AlexPeirano/neck_cst_simulation/README.md

# neck_cst_simulation
This repository contains scripts to analyse CST simulations of a modeled neck and antennas.
