AlexPeirano/neck_cst_simulation/final/diapo_final.pptx.pdf

# Design and Manufacturing of Low-Cost Antennas for

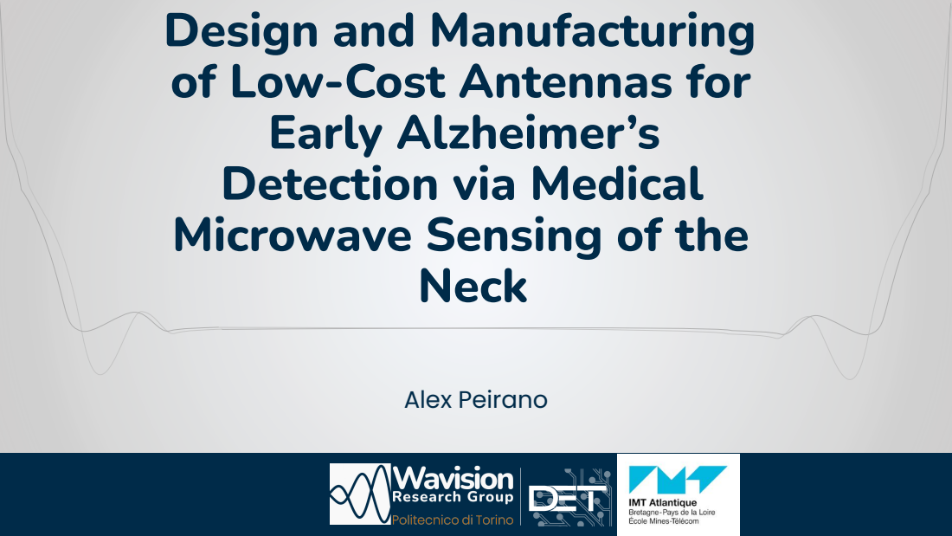
[picture p1: page 1]
Neck; Alex Peirano

Early Alzheimer’s
Detection via Medical
Microwave Sensing of the

# MultiTissue block

# CST Model Coupling

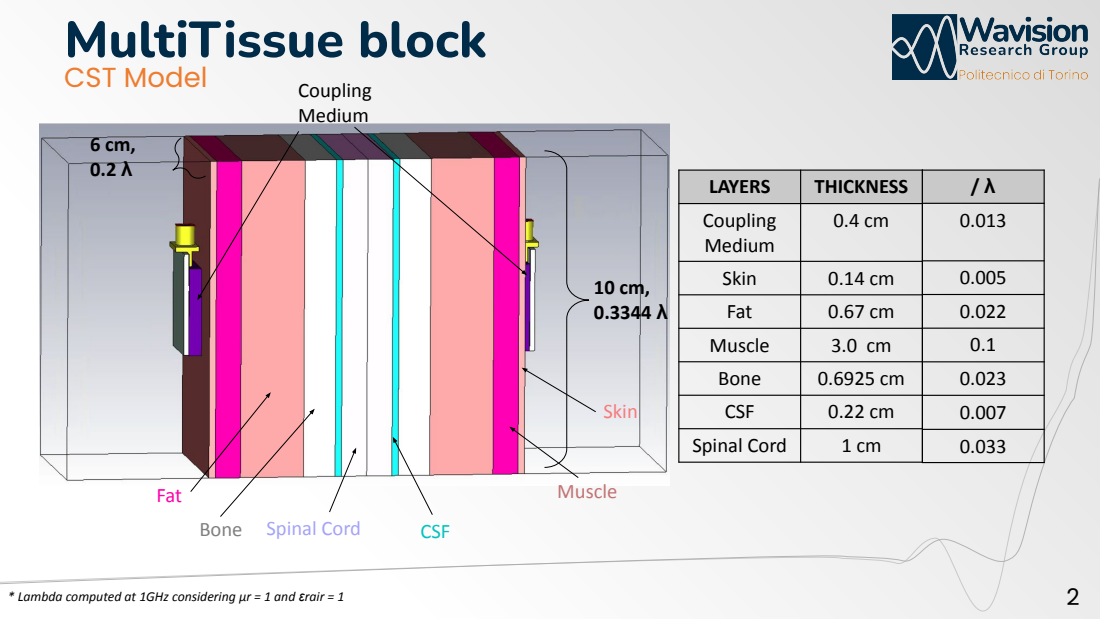
[picture p2: page 2]
Medium; Skin; Fat; Muscle; Bone; Spinal Cord; CSF; * Lambda computed at 1GHz considering μr = 1 and ɛrair = 1

LAYERS | THICKNESS | / λ
Coupling Medium | 0.4 cm | 0.013

Fat | 0.67 cm | 0.022
Muscle | | 3.0 cm | 0.1
Bone | | 0.6925 cm | 0.023

# Simulations Boundary conditions

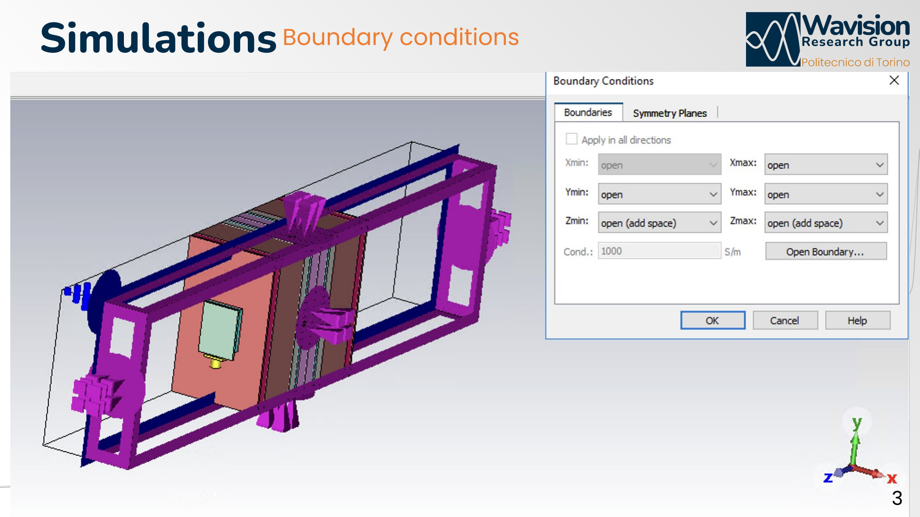
[picture p3: page 3]

3

# Simulations Boundary conditions

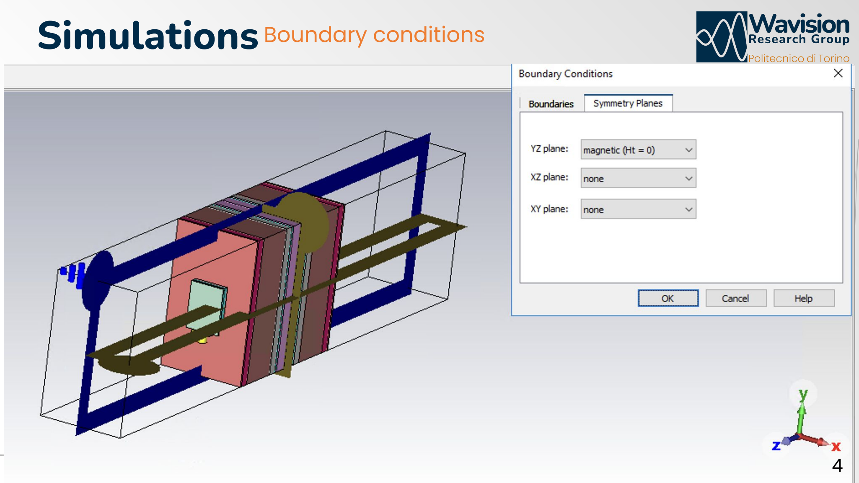
[picture p4: page 4]

4

# Simulations

# Refining the mesh

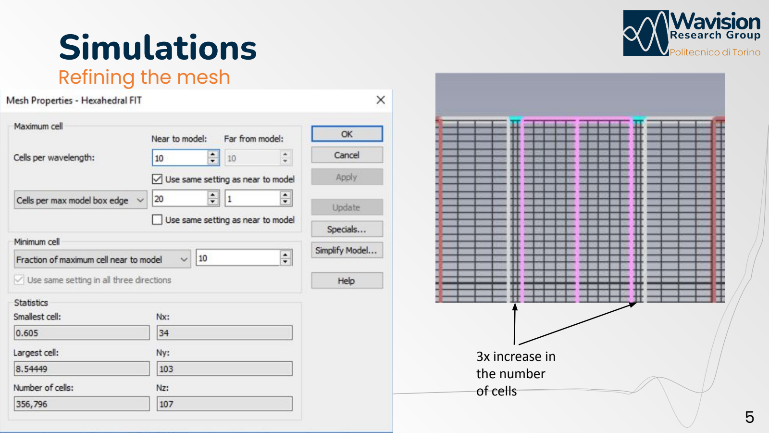
[picture p5: page 5]

5

## 3x increase in the number of cells

24 mm

# Optimized Antenna Ring topology

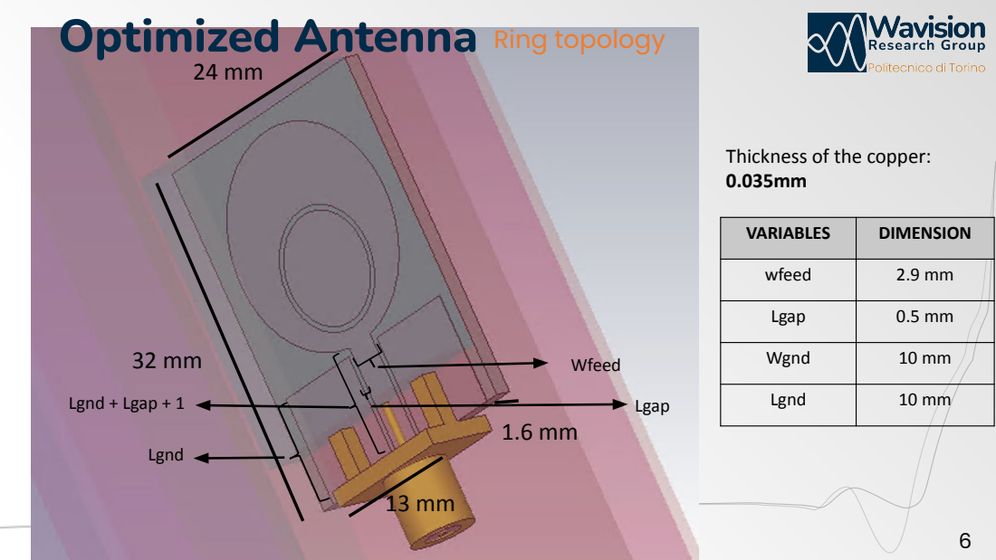
[picture p6: page 6]
Wfeed; Lgnd; Lgnd + Lgap + 1; Lgap

Thickness of the copper:

VARIABLES | DIMENSION

wfeed | 2.9 mm

Lgap | 0.5 mm

Wgnd | 10 mm

# Optimized Antenna Ring topology

LAYERS | DIMENSION
R_ext | R_m - w_slot/2
R_int | R_m + w_slot/2
R_m | 4.03 mm
w_slot | 0.5 mm

7

## R_ext

## R_int R_m

LAYERS | DIMENSION

## Y_offset

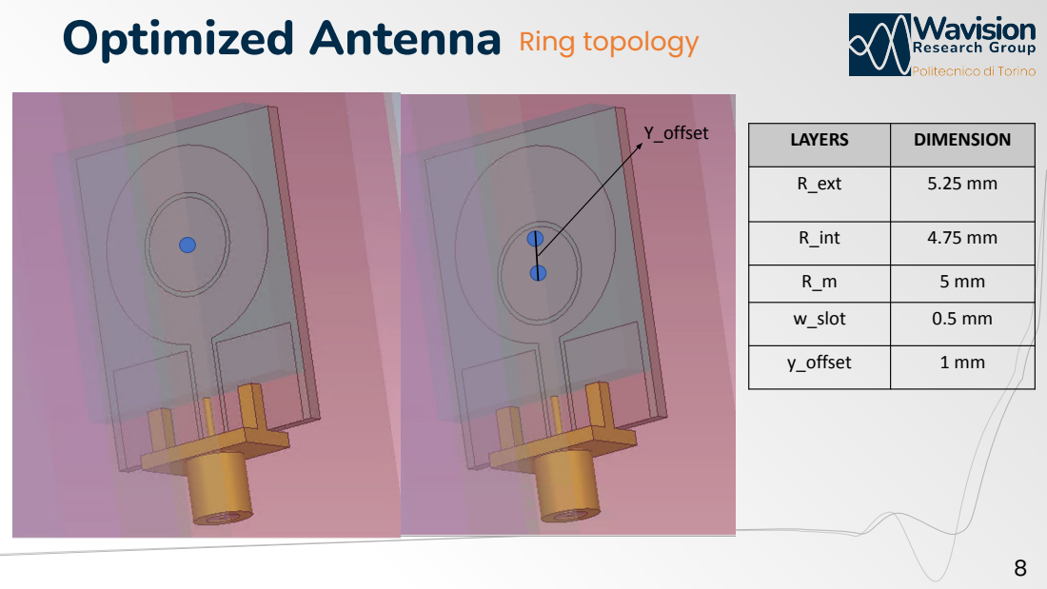
[picture p7: page 8]

Optimized Antenna Ring topology

R_ext | 5.25 mm

R_int | 4.75 mm

w_slot | 0.5 mm

y_offset | 1 mm

# Preliminary computations

# Ring Topology

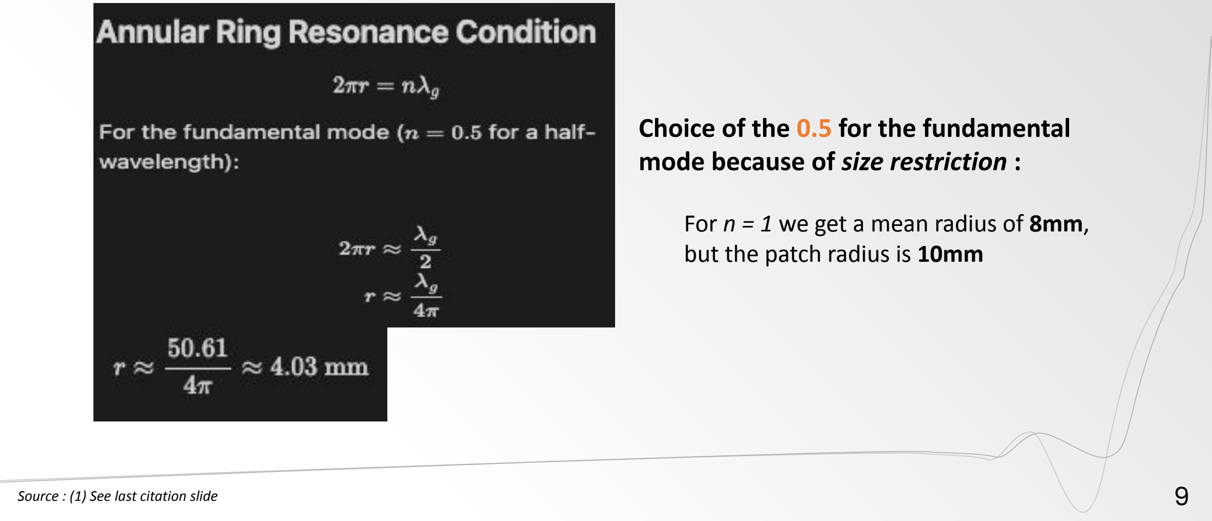
[picture p8: figure]
Choice of the 0.5 for the fundamental mode because of size restriction :; For n = 1 we get a mean radius of 8mm, but the patch radius is 10mm; Source : (1) See last citation slide

# Simulations

# Ring topology

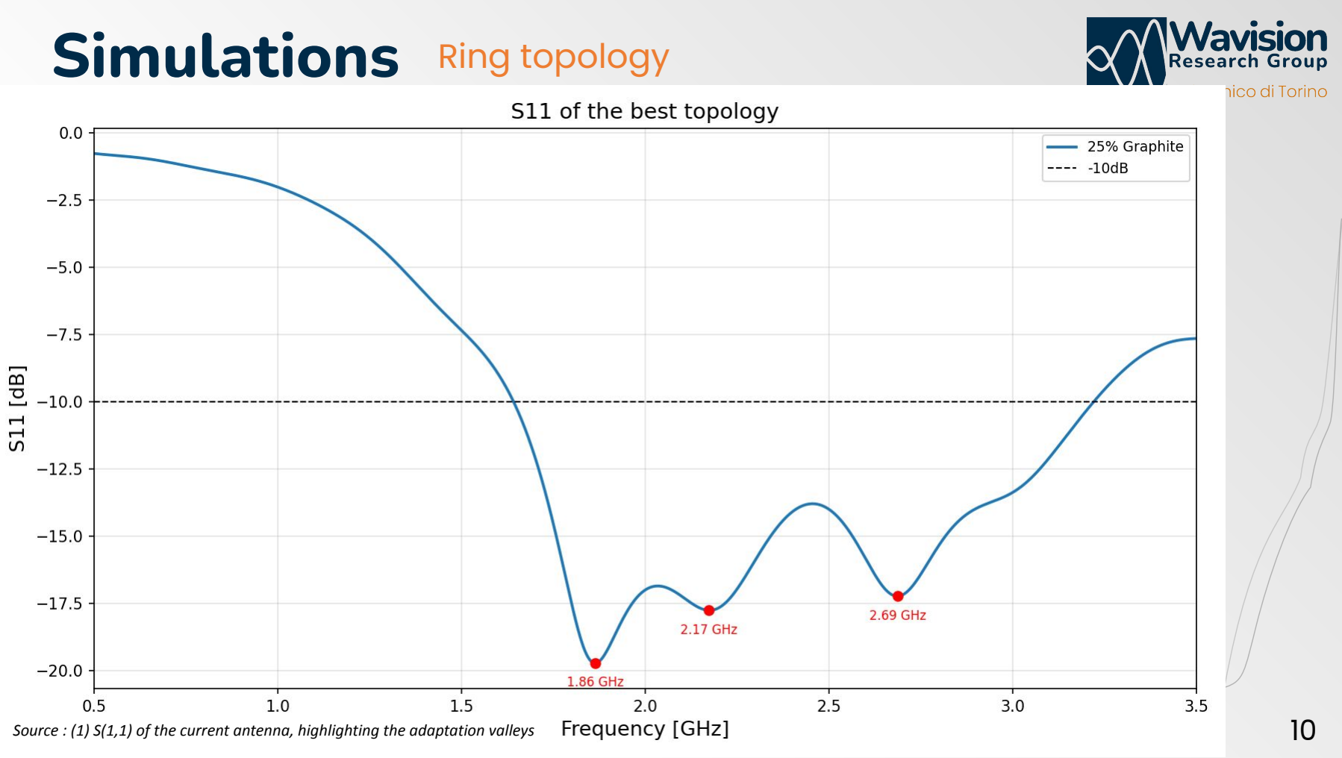
[picture p9: page 10]

Source : (1) S(1,1) of the current antenna, highlighting the adaptation valleys | 10

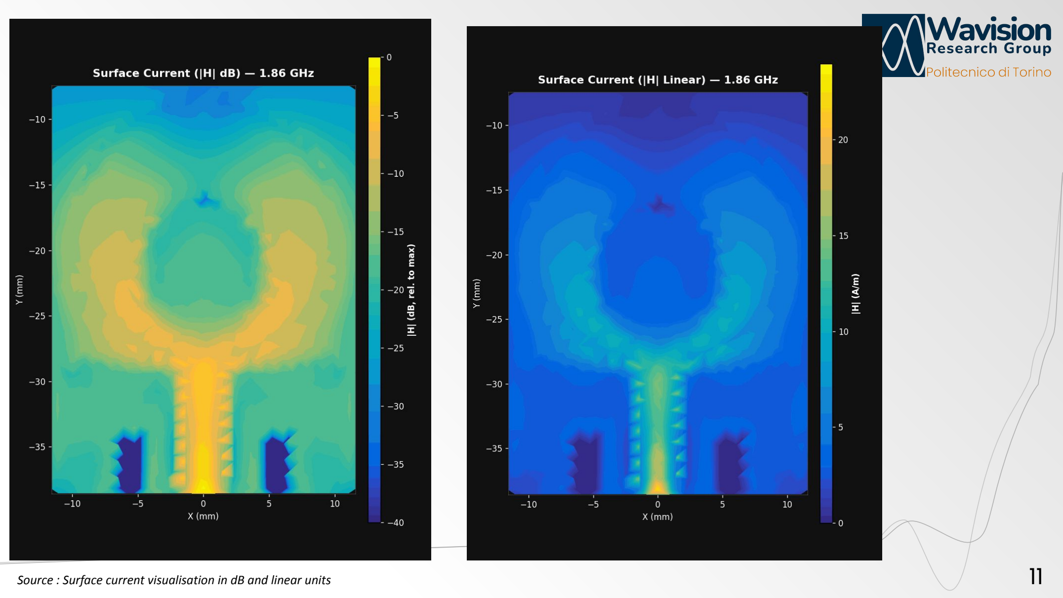
[picture p10: page 11]

Source : Surface current visualisation in dB and linear units | 11

1) | 2) | 3)

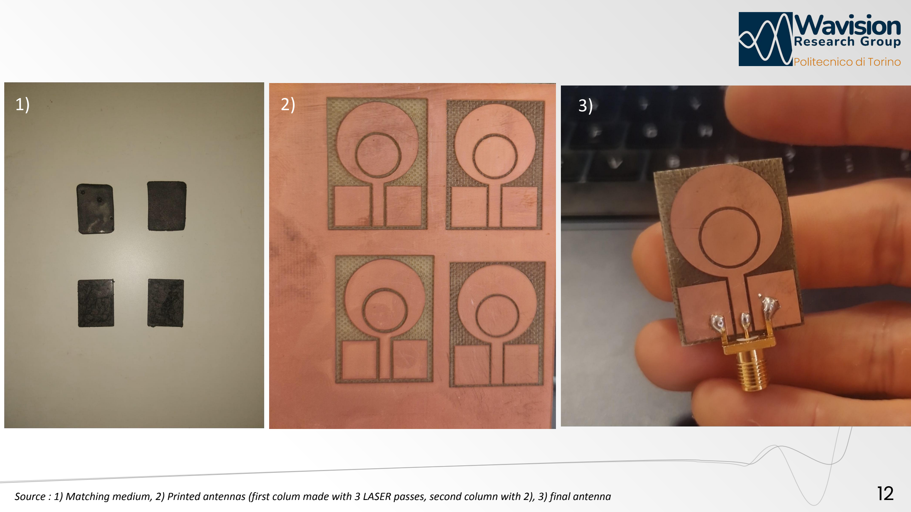
[picture p11: page 12]

Source : 1) Matching medium, 2) Printed antennas (first colum made with 3 LASER passes, second column with 2), 3) final antenna | 12

# Simulations

# Ring topology

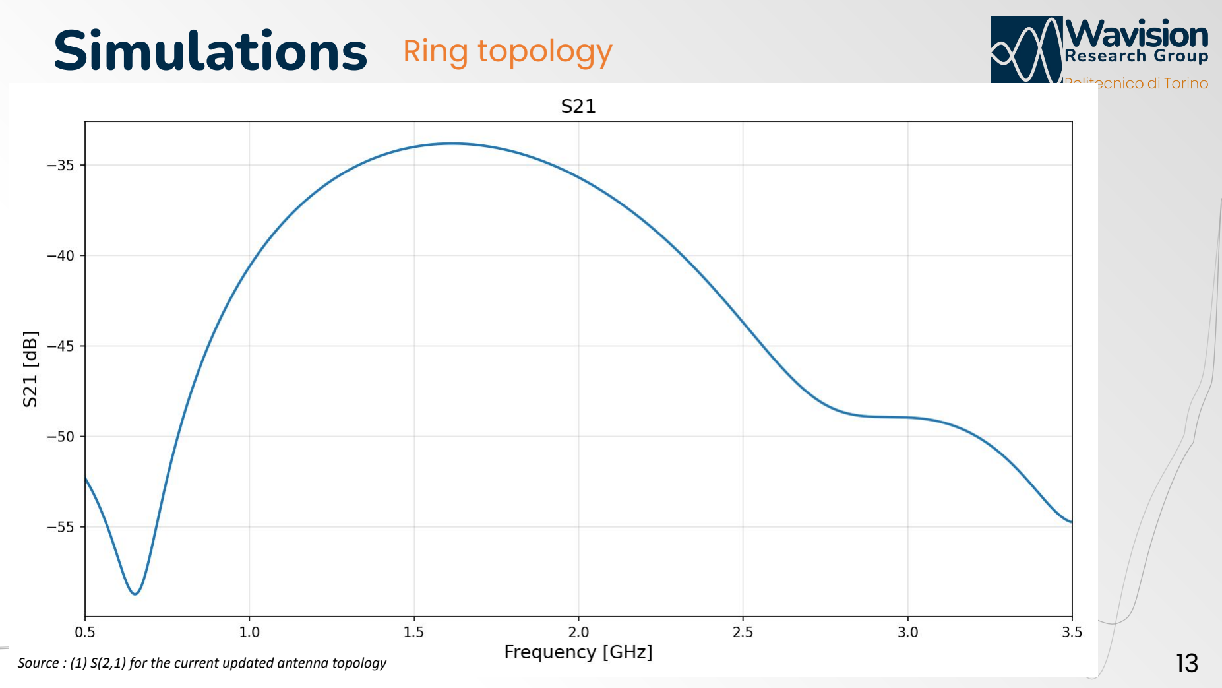
[picture p12: page 13]

Source : (1) S(2,1) for the current updated antenna topology | 13

Simulations | Electric Field (dB)

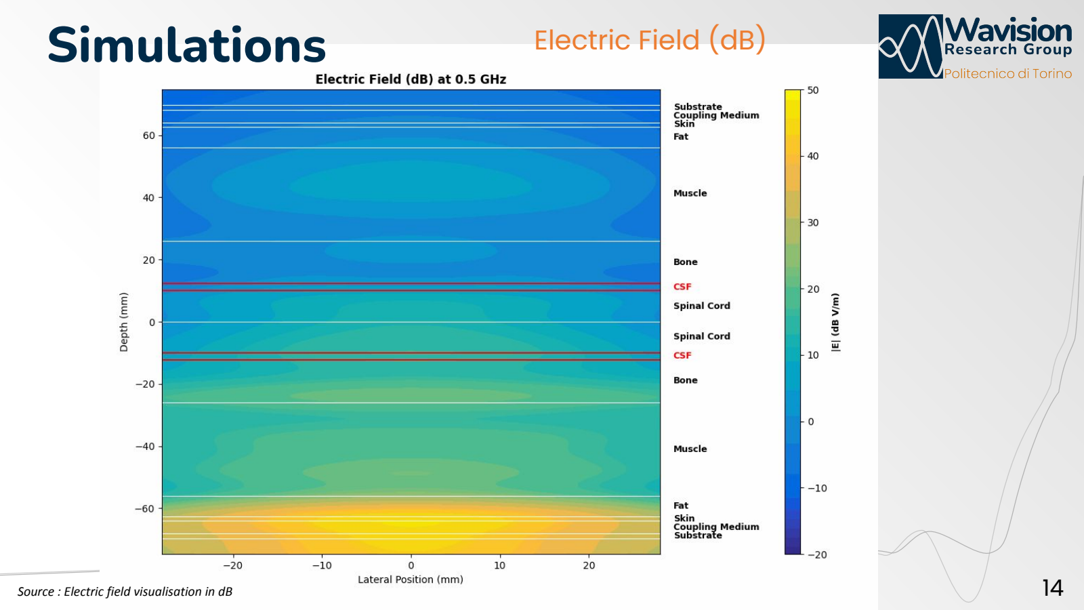
[picture p13: page 14]

| 14

Source : Electric field visualisation in dB

Simulations | E-field (linear)

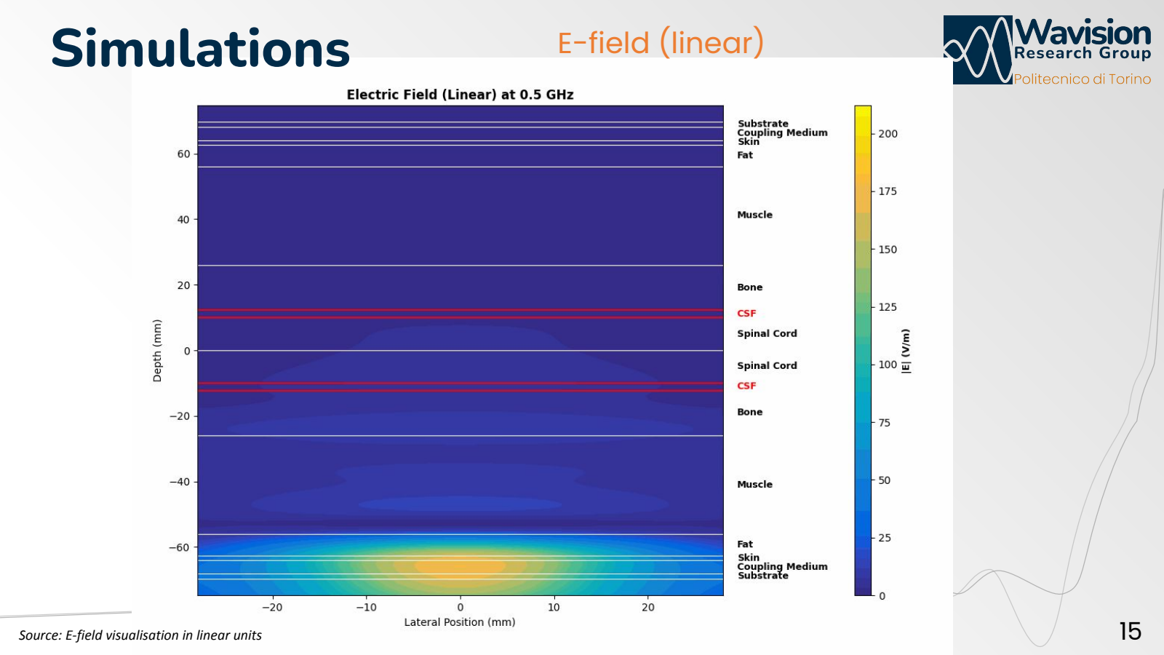
[picture p14: page 15]

| 15

Source: E-field visualisation in linear units

# Simulations Normalized E-field (dB)

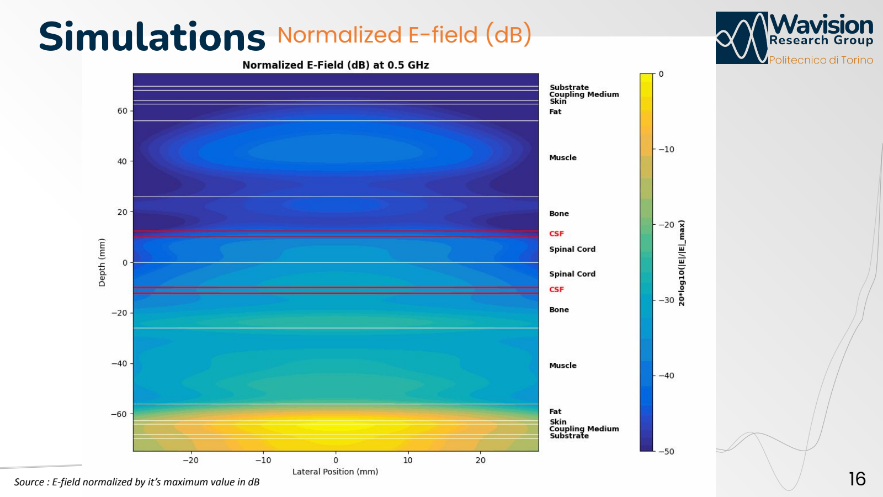
[picture p15: page 16]

| 16

Source : E-field normalized by it’s maximum value in dB

# Simulations Normalized E-field visualization

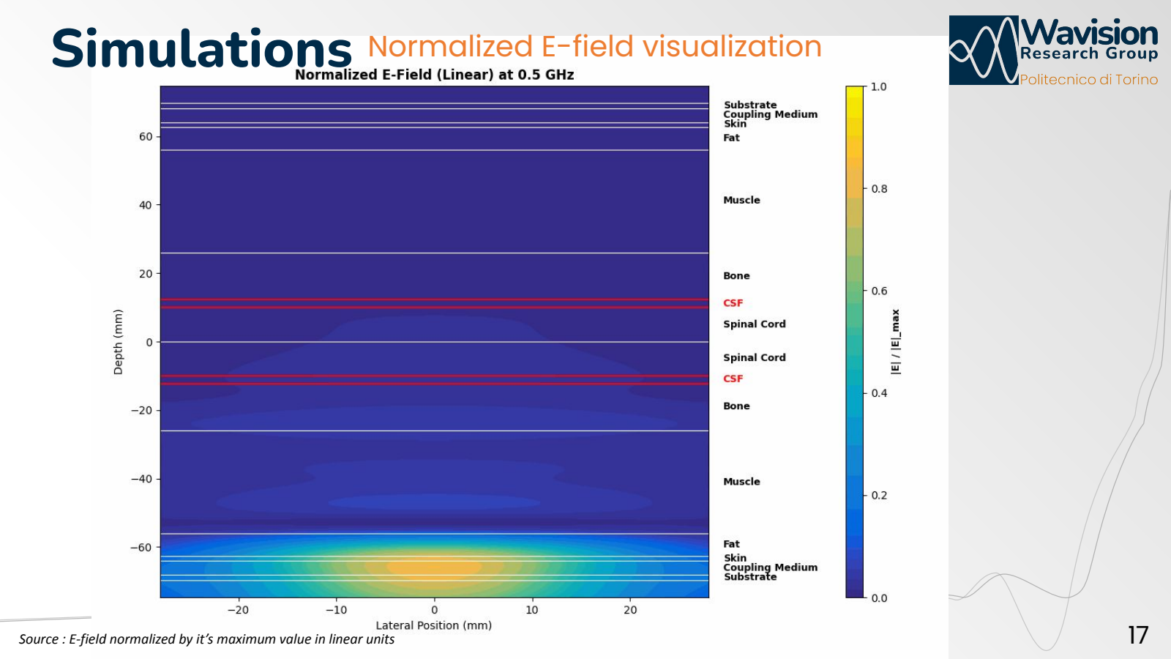
[picture p16: page 17]

| 17

Source : E-field normalized by it’s maximum value in linear units

# Simulations Changing the % of graphite

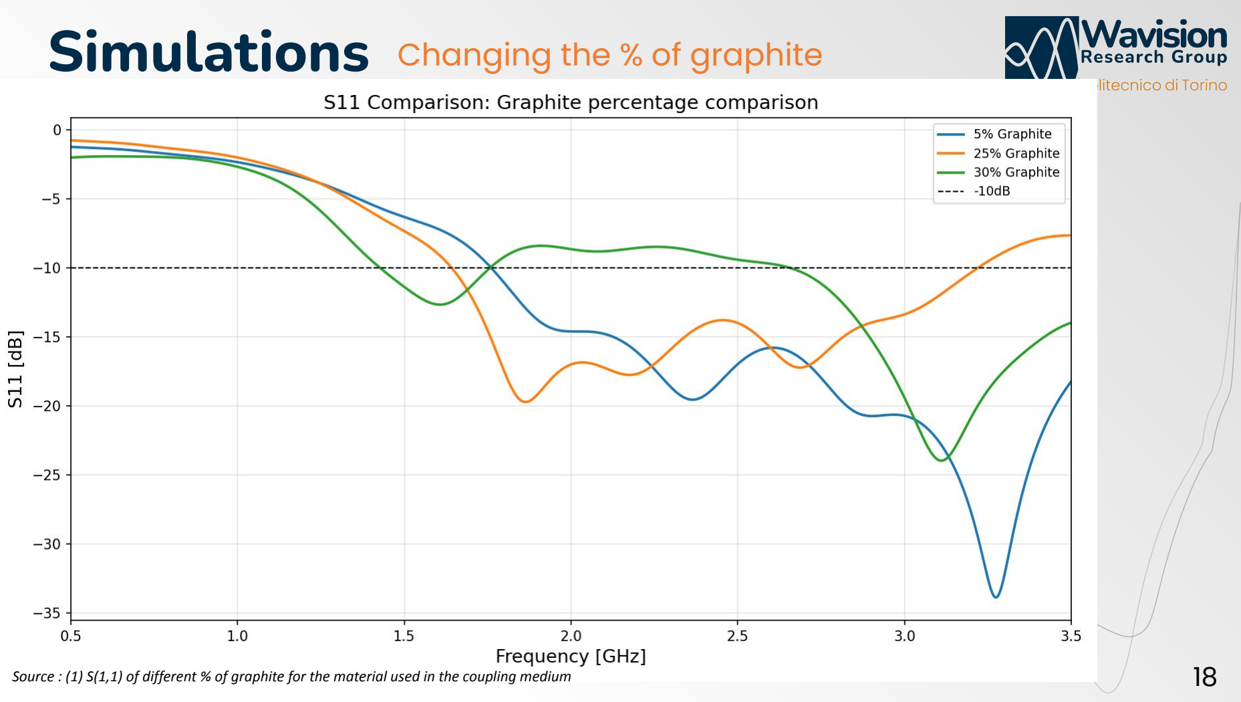
[picture p17: page 18]

Source : (1) S(1,1) of different % of graphite for the material used in the coupling medium | 18

# Simulations

# Changing the % of graphite

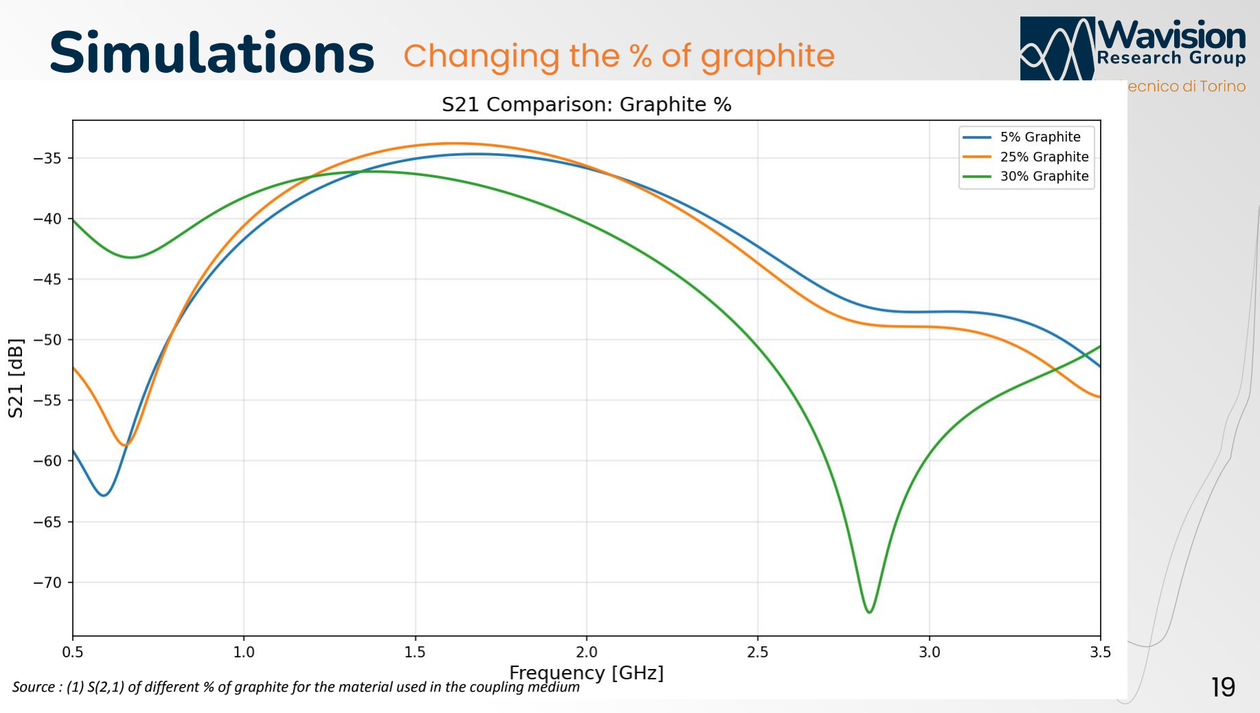
[picture p18: page 19]

Source : (1) S(2,1) of different % of graphite for the material used in the coupling medium | 19

# Neck thickness

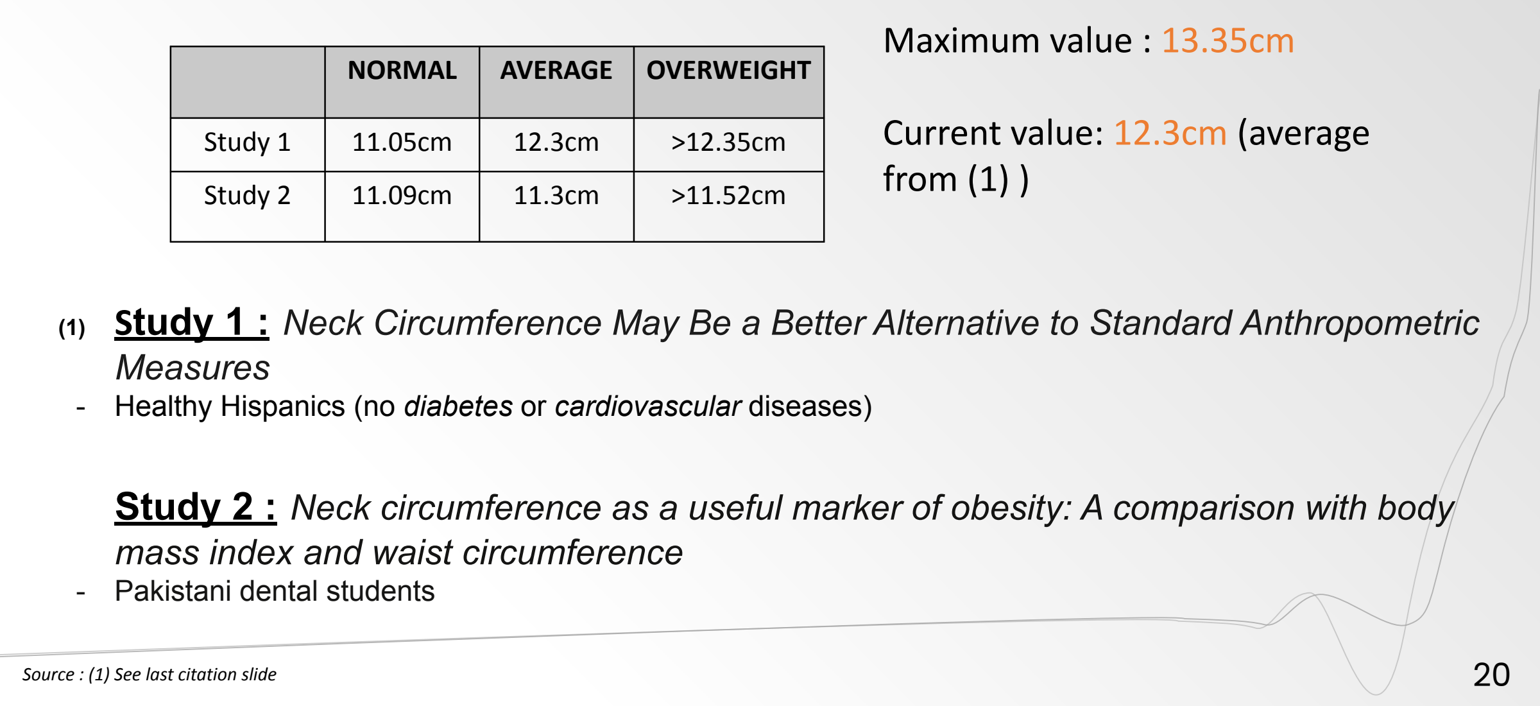
[picture p19: figure]
NORMAL; AVERAGE; OVERWEIGHT; Study 1; Study 2; Measures; mass index and waist circumference; - Pakistani dental students; Maximum value : 13.35cm; Current value: 12.3cm (average from (1) ); Source : (1) See last citation slide

(1) | Study 1 : | Neck Circumference May Be a Better Alternative to Standard Anthropometric

## - Healthy Hispanics (no diabetes or cardiovascular diseases)

| Study 2 : | Neck circumference as a useful marker of obesity: A comparison with body

# MultiTissue block

# Thicker models

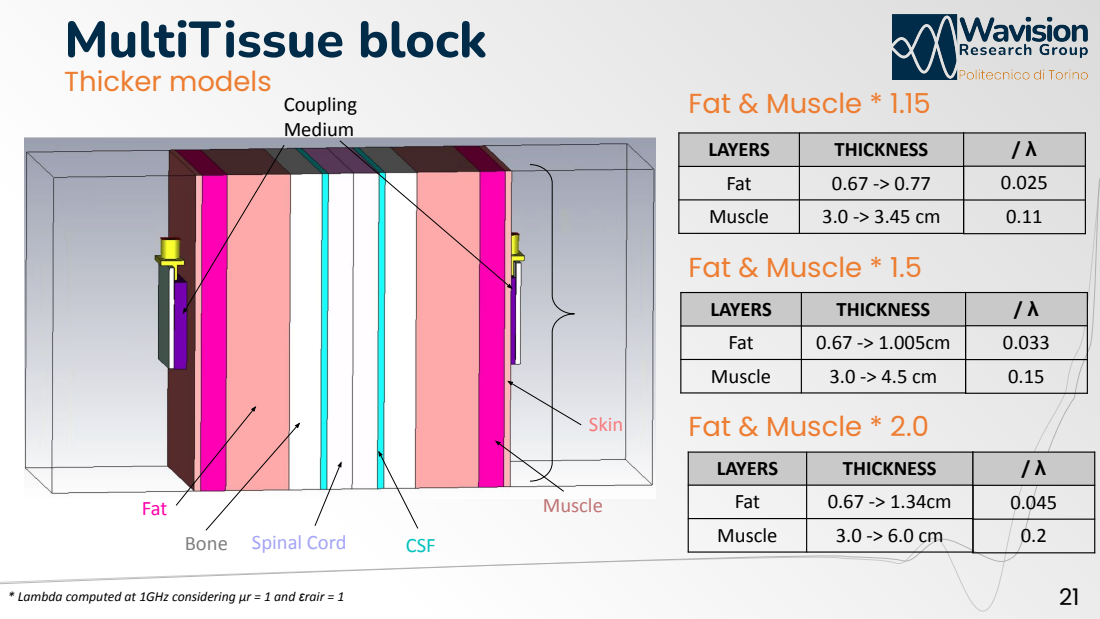
[picture p20: page 21]
Coupling Medium; Skin; Fat; Muscle; Bone; Spinal Cord; CSF; * Lambda computed at 1GHz considering μr = 1 and ɛrair = 1; Fat & Muscle * 1.15; Fat & Muscle * 1.5; Fat & Muscle * 2.0

LAYERS | THICKNESS | / λ
Fat | 0.67 -> 0.77 | 0.025
Muscle | 3.0 -> 3.45 cm | 0.11

Fat | 0.67 -> 1.005cm | 0.033
Muscle | 3.0 -> 4.5 cm | 0.15

Fat | 0.67 -> 1.34cm | 0.045
Muscle | 3.0 -> 6.0 cm | 0.2

# Simulations Thicker necks

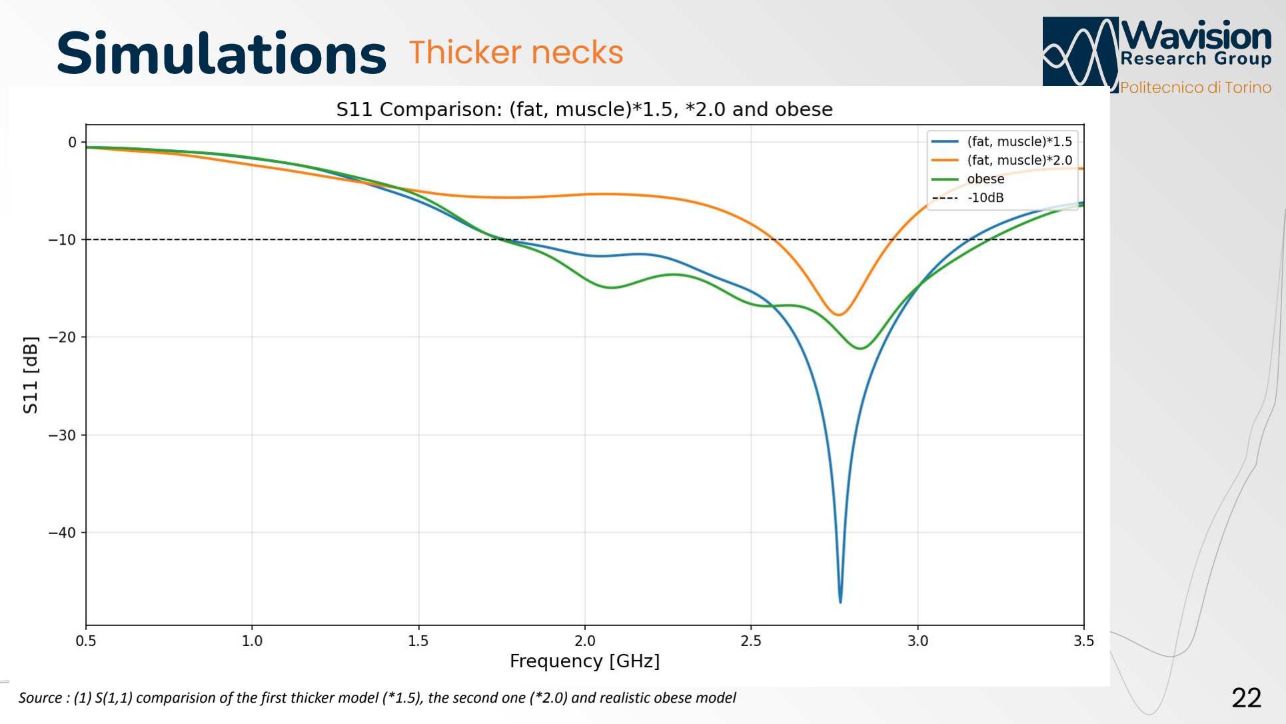
[picture p21: page 22]

Source : (1) S(1,1) comparision of the first thicker model (*1.5), the second one (*2.0) and realistic obese model | 22

# Simulations

# Thicker necks

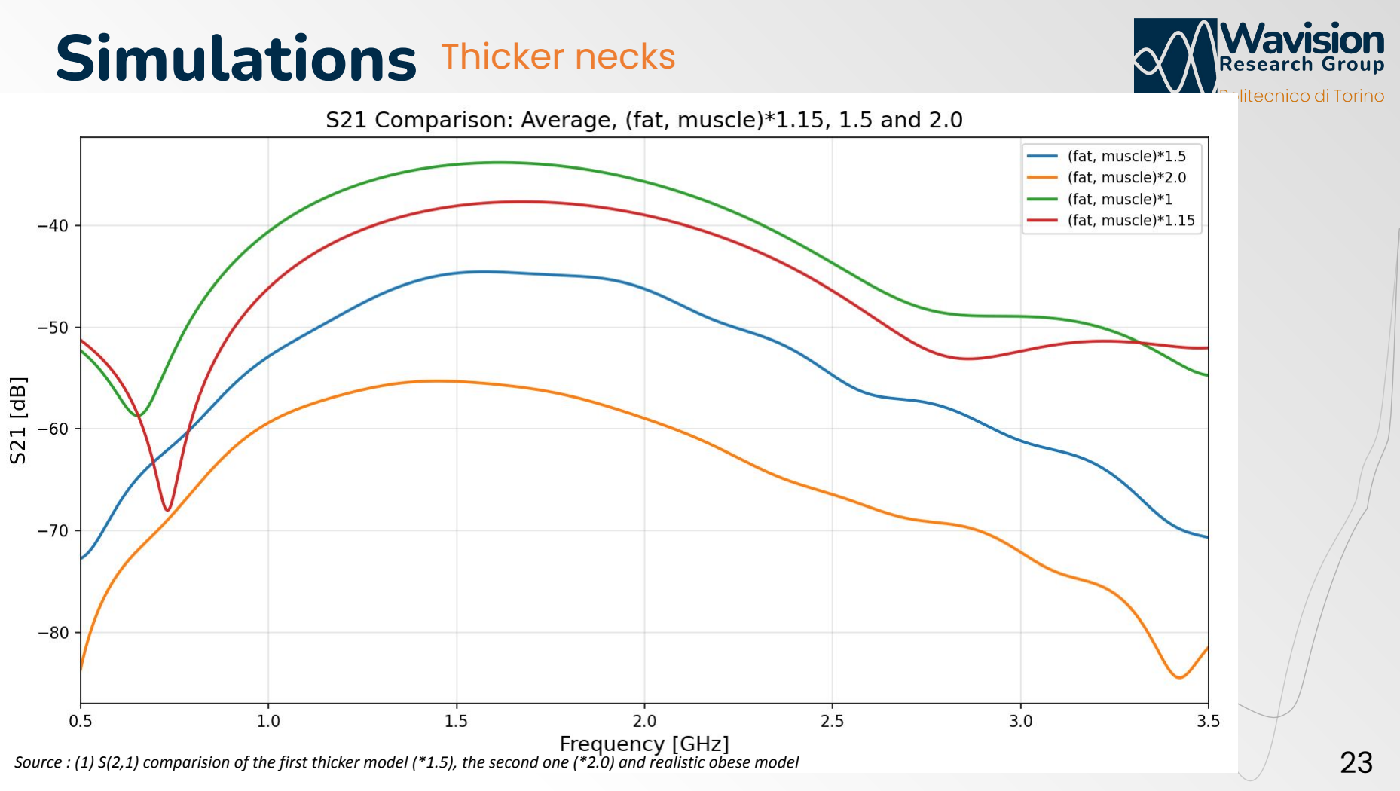
[picture p22: page 23]

Source : (1) S(2,1) comparision of the first thicker model (*1.5), the second one (*2.0) and realistic obese model | 23

# Simulations Electric Field (dB) realistic obese

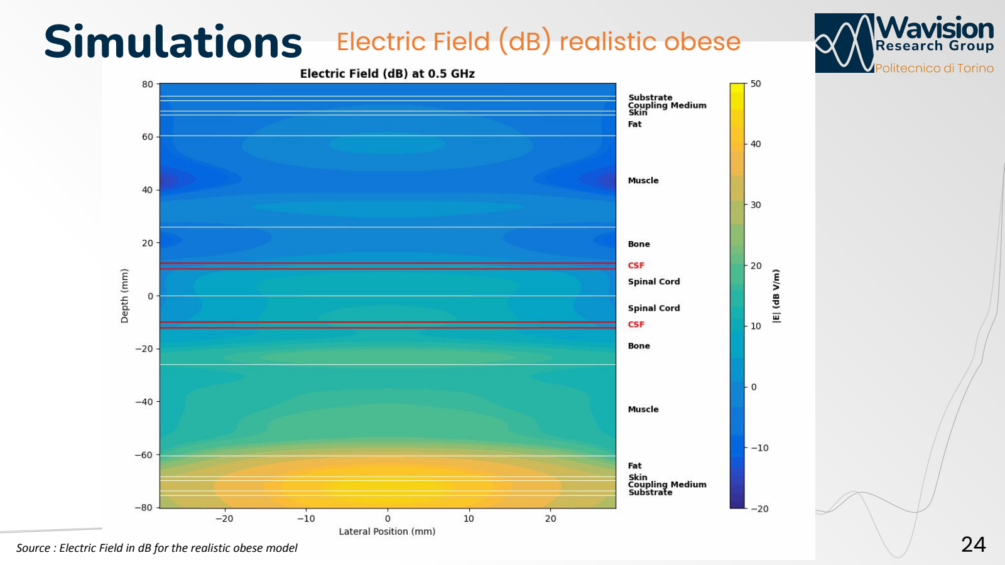
[picture p23: page 24]

| 24

Source : Electric Field in dB for the realistic obese model

# Simulations

# Electric Field (linear) realistic obese

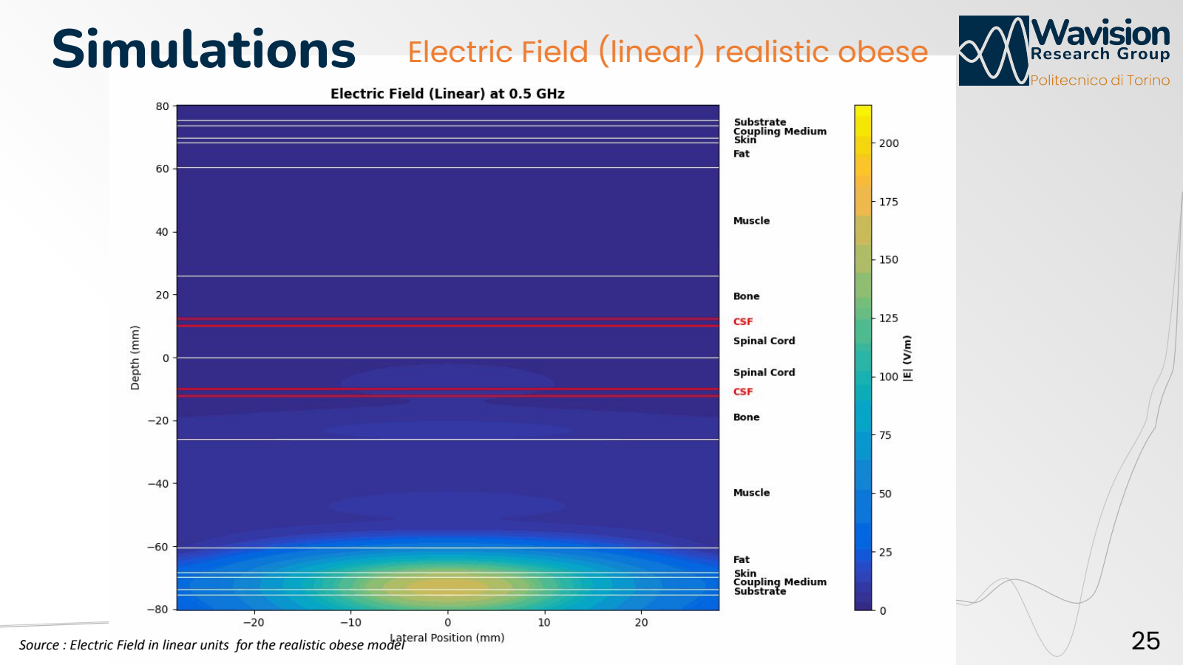
[picture p24: page 25]

25
Source : Electric Field in linear units for the realistic obese model

# Simulations

# Normalised Electric Field (dB) realistic obese

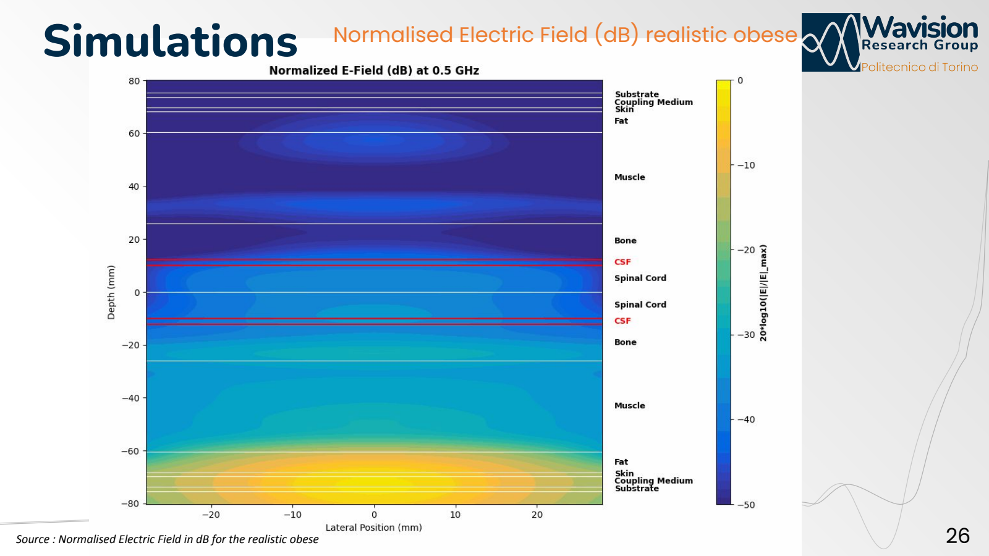
[picture p25: page 26]

26
Source : Normalised Electric Field in dB for the realistic obese

# Simulations

# Nomalised Electric Field (linear) realistic obese

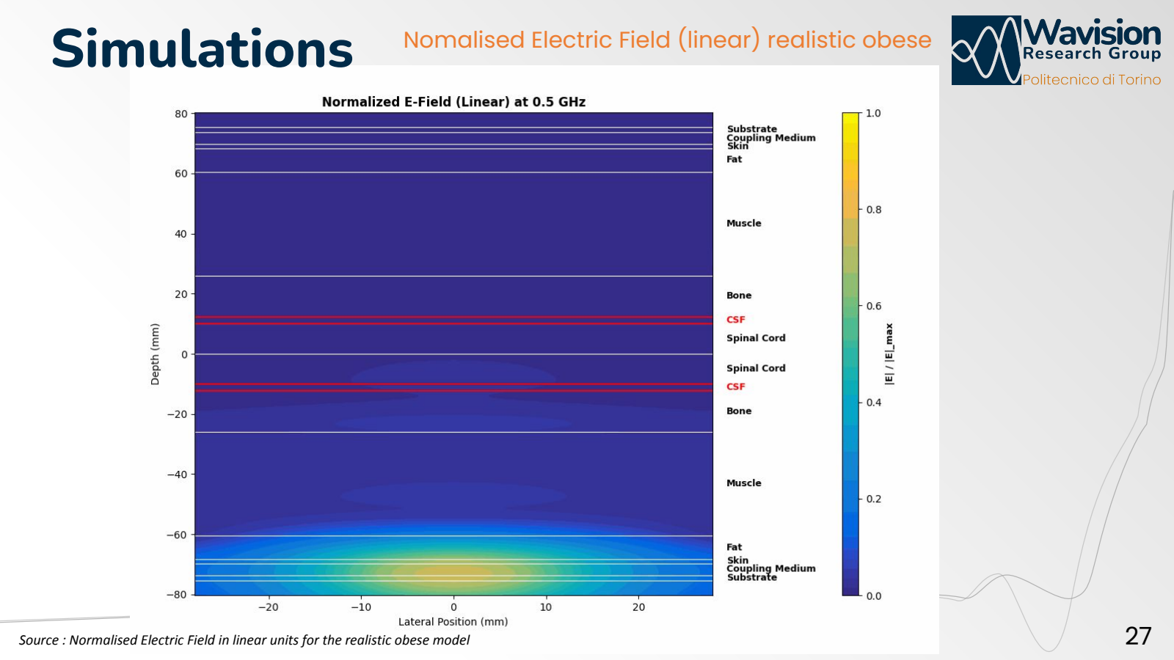
[picture p26: page 27]

27
Source : Normalised Electric Field in linear units for the realistic obese model

# Experiments

# Average Neck

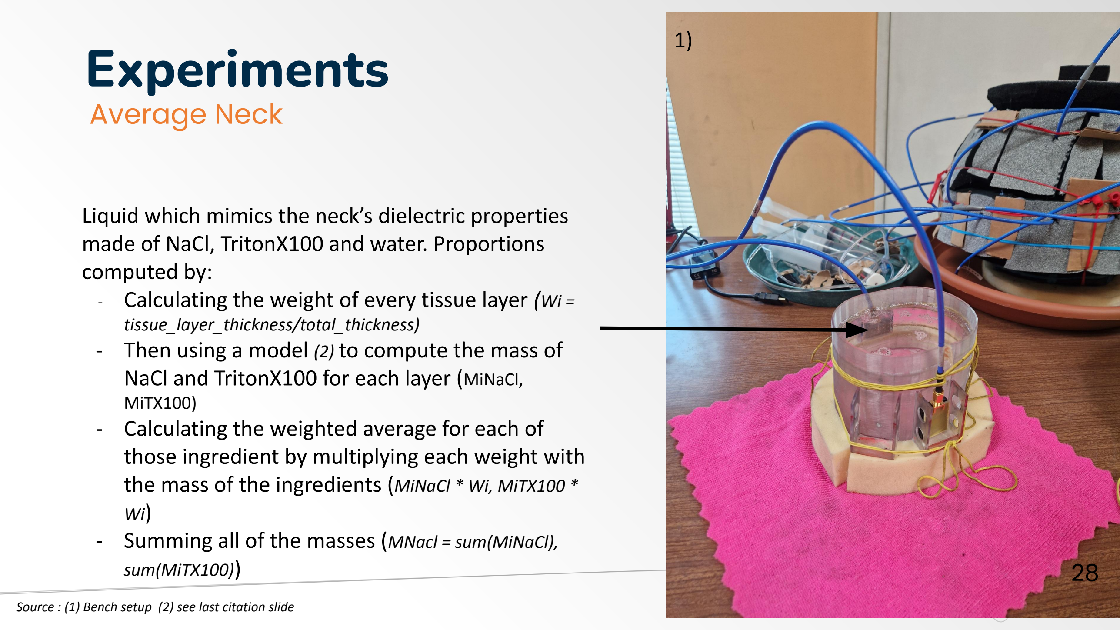
[picture p27: page 28]

28

1)

## Liquid which mimics the neck’s dielectric properties made of NaCl, TritonX100 and water. Proportions computed by: - Calculating the weight of every tissue layer

(Wi =
| tissue_layer_thickness/total_thickness)

## - Then using a model (2) to compute the mass of

| NaCl and TritonX100 for each layer (MiNaCl, MiTX100)

## - Calculating the weighted average for each of

| those ingredient by multiplying each weight with the mass of the ingredients (MiNaCl * Wi, MiTX100 * Wi)
- Summing all of the masses (MNacl = sum(MiNaCl),
| sum(MiTX100))

Source : (1) Bench setup (2) see last citation slide

29

# Experiments

# Average Neck

The antennas were made in LED by using a LASER engraver, with one batch of two antennas made by

## passing the LASER 5 times (A5) and the other one 6 times (A6) On each experiment the 1st port corresponds to A6 and the 2nd to A5

The matching mediums were made in the DET lab with a two part rubber mixture and graphite, one with a 5% (by mass) of graphite the other with 20%. Then poured into a 3D printed PLA mould.
A 25% and a 30% mixture were attempted, but the rubber did not cure properly.

## The bench is composed of a VNA, phase stable coaxial cables, SLIM-4 probe

A 1000 kHz IF filter was chosen on the VNA software.

## Then the simulations files were exported as touchstones files and plotted using Python3.0

# Experiments

# Average Neck

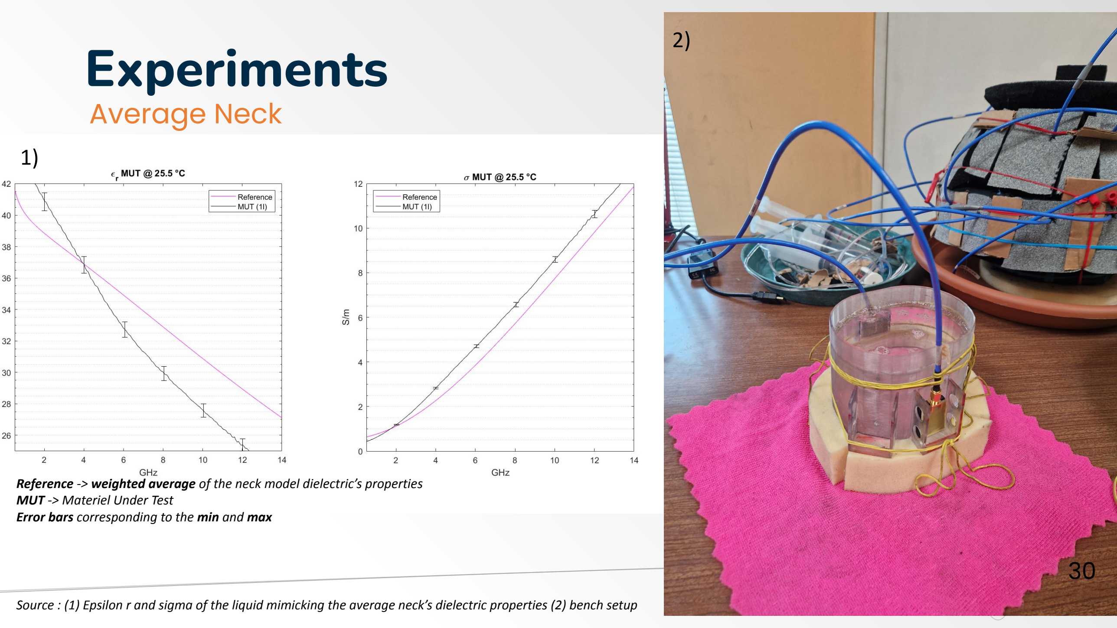
[picture p28: page 30]

30

| 1)

Source : (1) Epsilon r and sigma of the liquid mimicking the average neck’s dielectric properties (2) bench setup

2)

Reference -> weighted average of the neck model dielectric’s properties MUT -> Materiel Under Test
Error bars corresponding to the min and max

# Experiments Neck Phantom

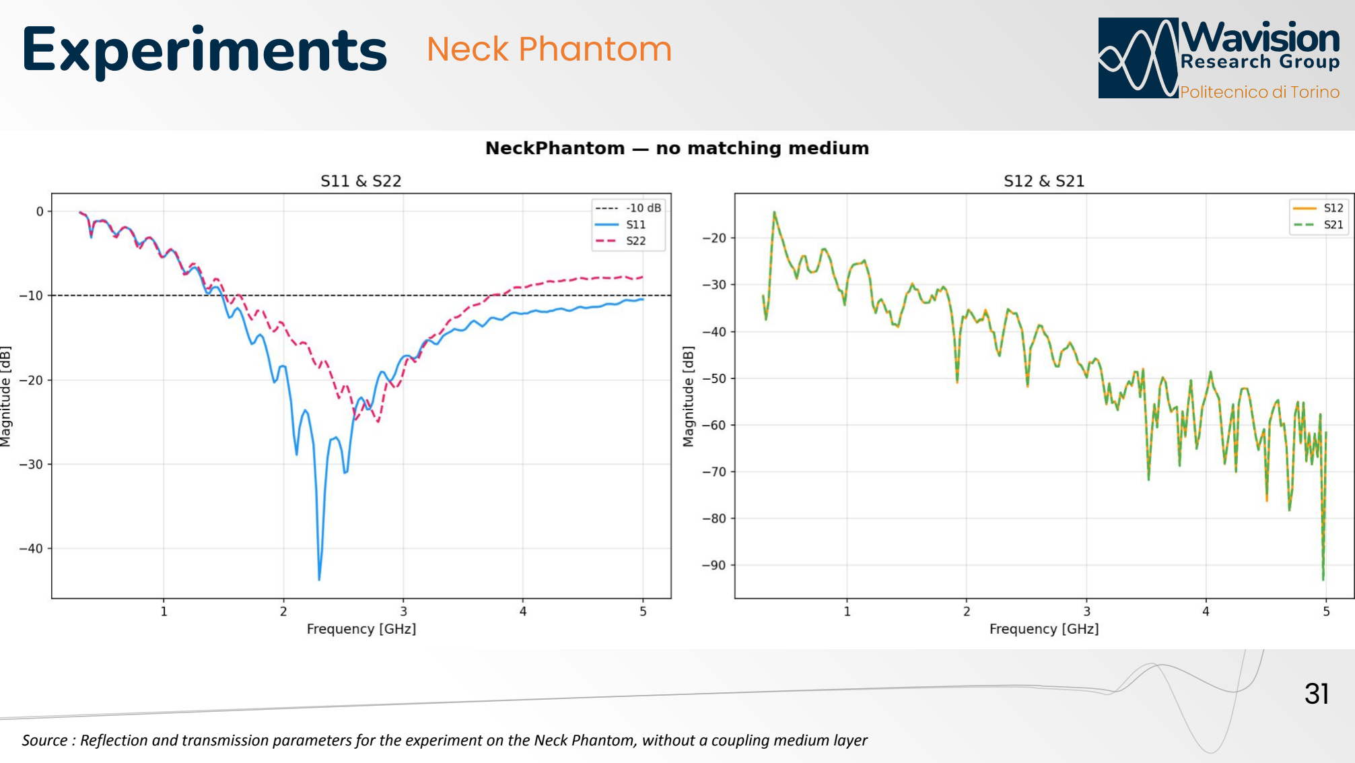
[picture p29: page 31]

31

Source : Reflection and transmission parameters for the experiment on the Neck Phantom, without a coupling medium layer

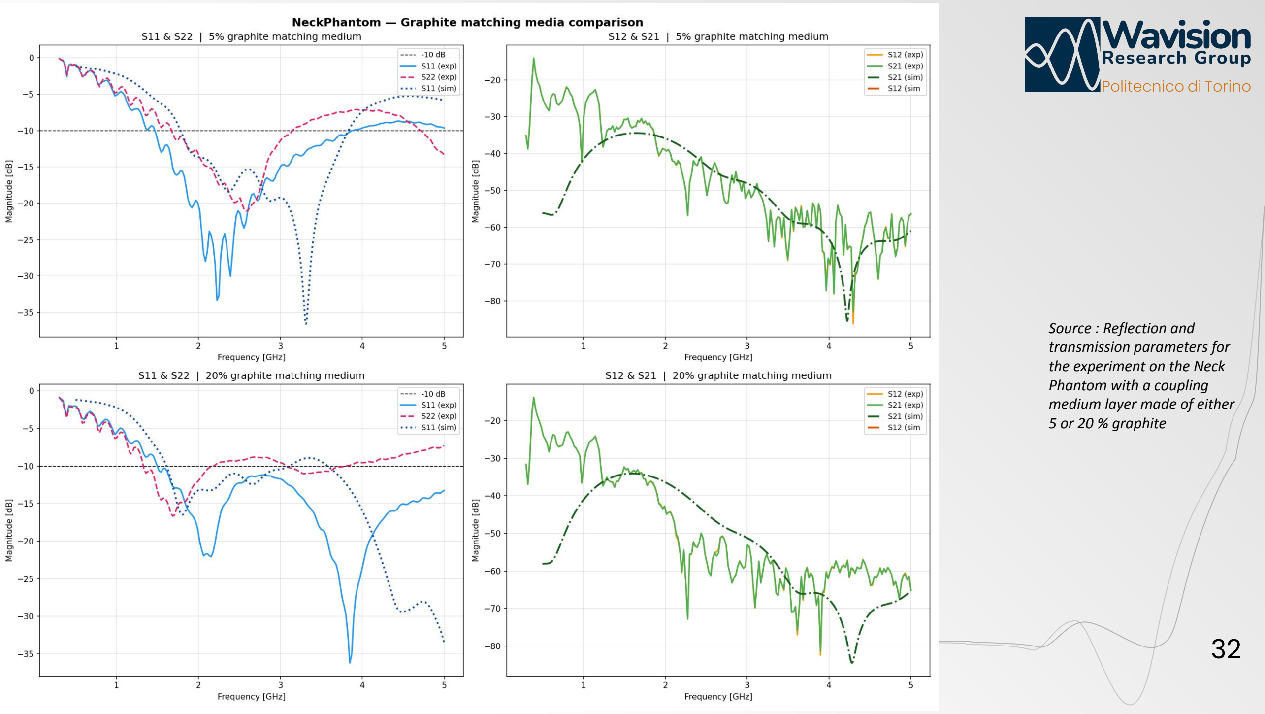
[picture p30: page 32]

32

Source : Reflection and
transmission parameters for the experiment on the Neck Phantom with a coupling
medium layer made of either 5 or 20 % graphite

# Experiments Head Phantom

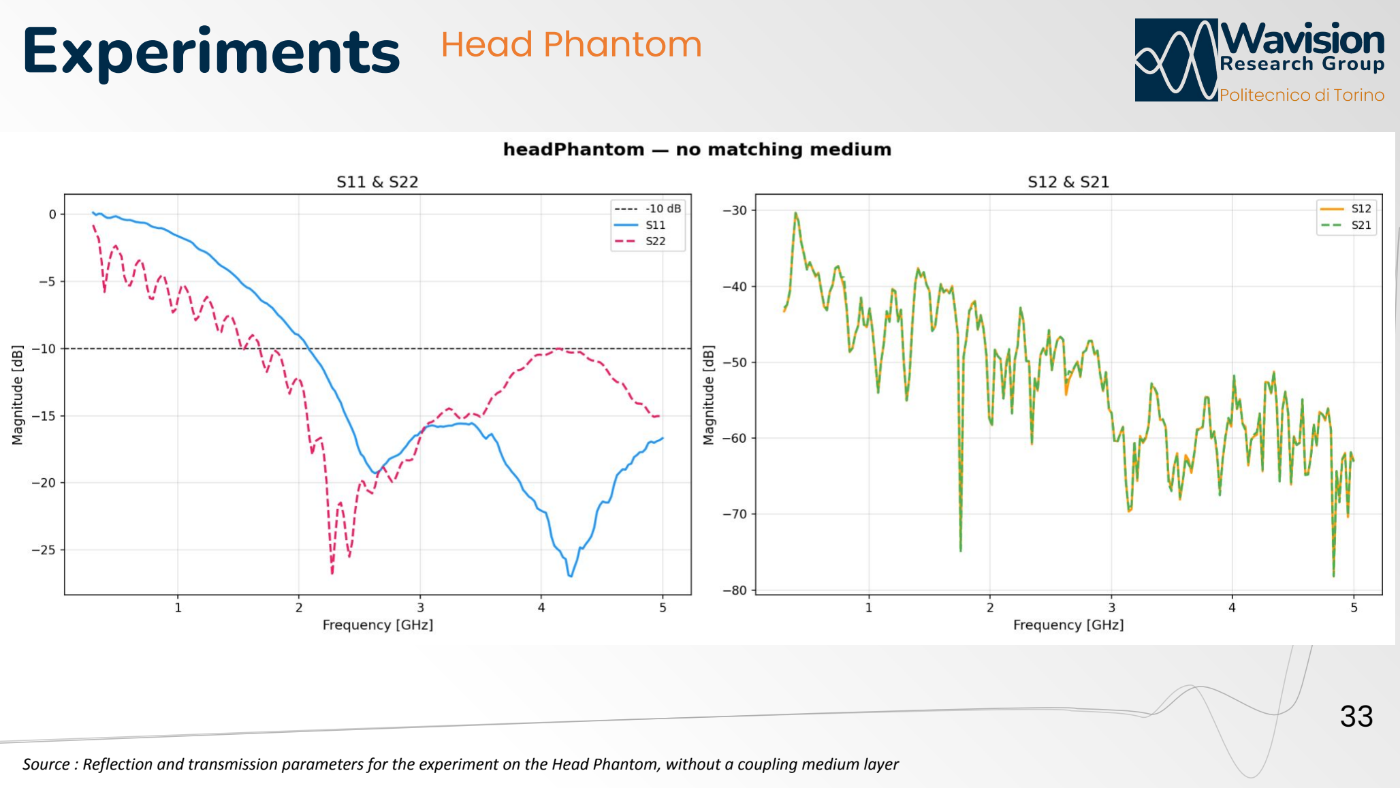
[picture p31: page 33]

33

Source : Reflection and transmission parameters for the experiment on the Head Phantom, without a coupling medium layer

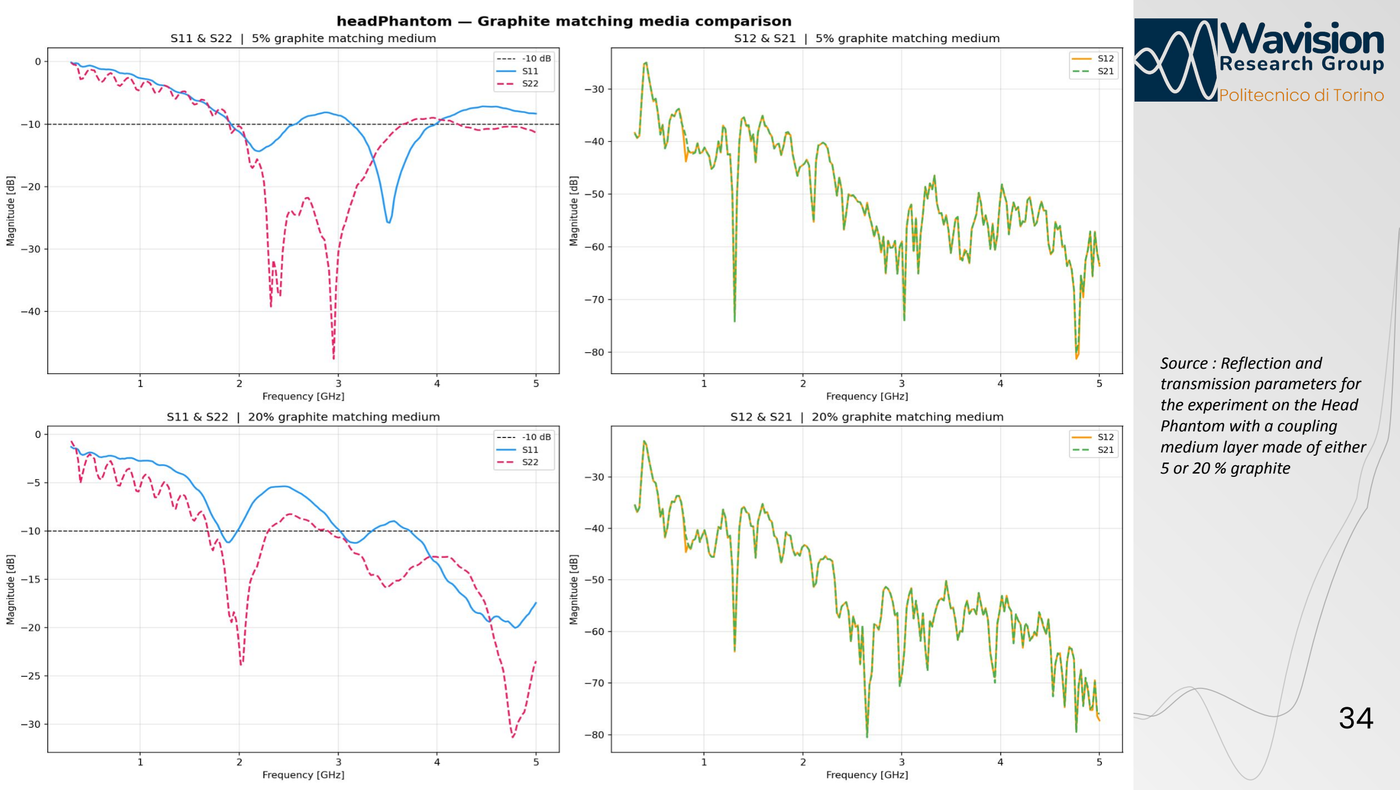
[picture p32: page 34]

34

Source : Reflection and
transmission parameters for the experiment on the Head Phantom with a coupling
medium layer made of either 5 or 20 % graphite

# Experiments Real Neck

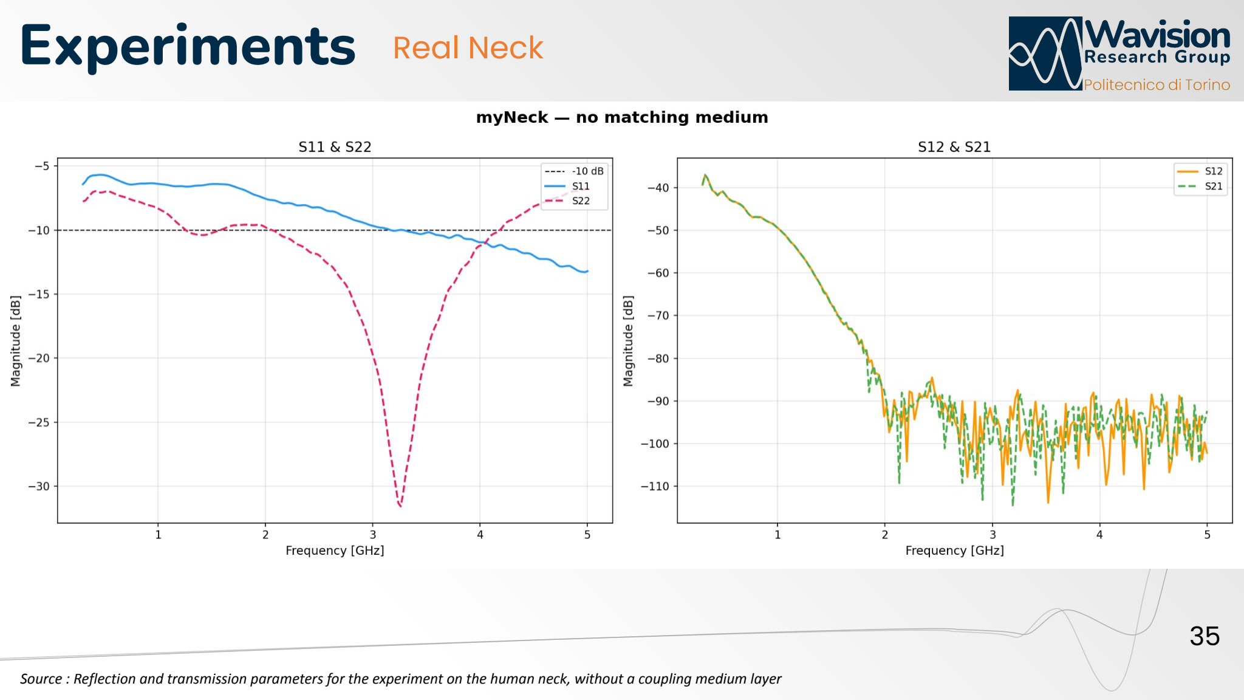
[picture p33: page 35]

35

Source : Reflection and transmission parameters for the experiment on the human neck, without a coupling medium layer

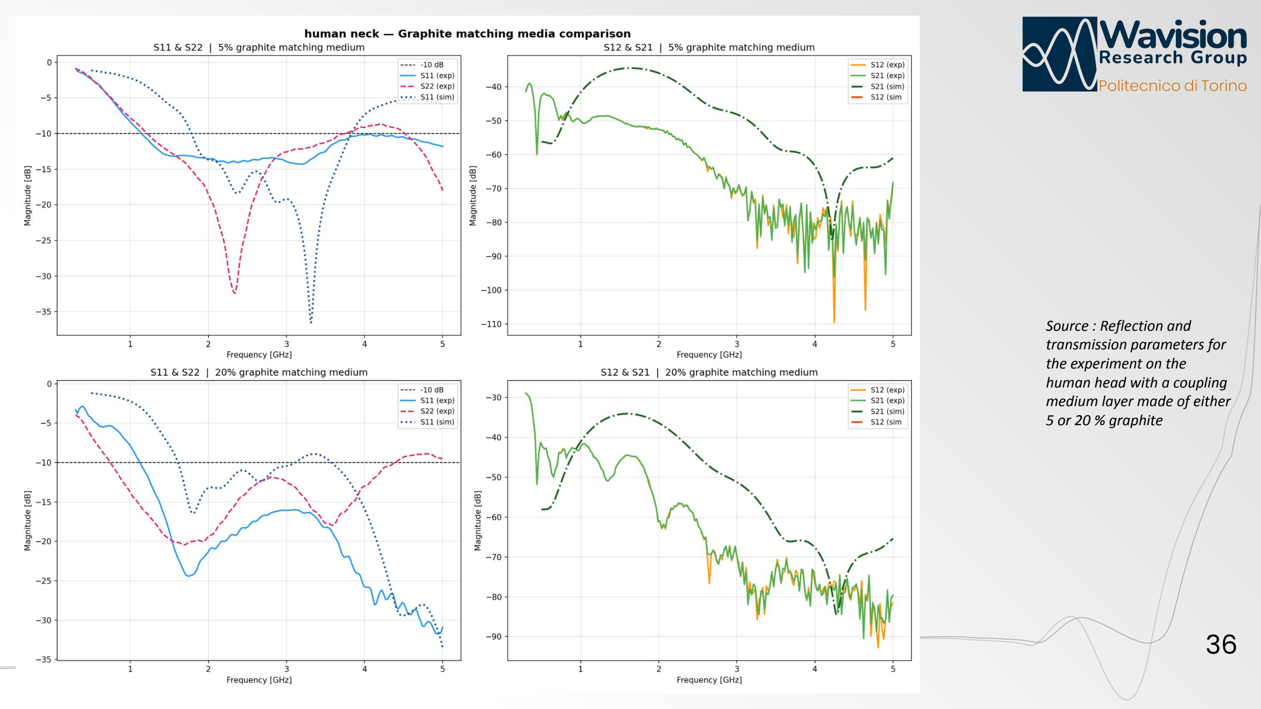
[picture p34: page 36]

36

Source : Reflection and
transmission parameters for the experiment on the
human head with a coupling medium layer made of either 5 or 20 % graphite

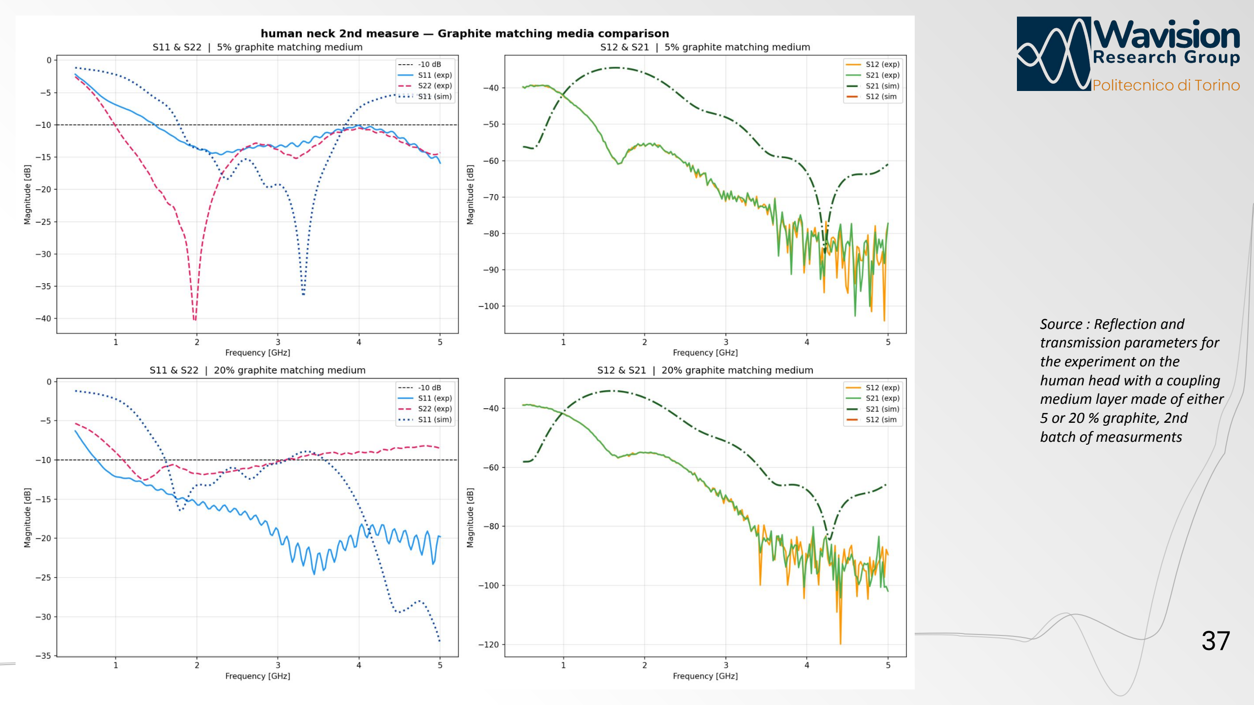
[picture p35: page 37]

37

Source : Reflection and
transmission parameters for the experiment on the
human head with a coupling medium layer made of either 5 or 20 % graphite, 2nd
batch of measurments

38

# Slide 19:

(1) Joshipura K, Muñoz-Torres F, Vergara J, Palacios C, Pérez CM. Neck Circumference May Be a Better Alternative to Standard Anthropometric Measures. J Diabetes Res. 2016;2016:6058916. doi: 10.1155/2016/6058916. Epub 2016 Feb 11. PMID: 26981543; PMCID: PMC4766356.
(2) Hingorjo MR, Qureshi MA, Mehdi A. Neck circumference as a useful marker of obesity: a comparison with body mass index and waist circumference. JPMA. The Journal of the Pakistan Medical Association. 2012 Jan;62(1):36-40. PMID: 22352099.

# Slide 9:

(2) K. Chang and L.-H. Hsieh, Microwave Ring Circuits and Related Structures, 2nd ed. Hoboken, NJ, USA: John Wiley & Sons, 2004.

# Slide 27:

[2] GeePs, "Simulation," 2023. [Online]. Available: https://applis.iut.univ-paris-diderot.fr/CNRS/simulation.php. [Accessed: Jul. 23, 2026].

# Citations
