AlexPeirano/neck_cst_simulation/antenna_simulations/SPARAMS/S11_goodmodel.png

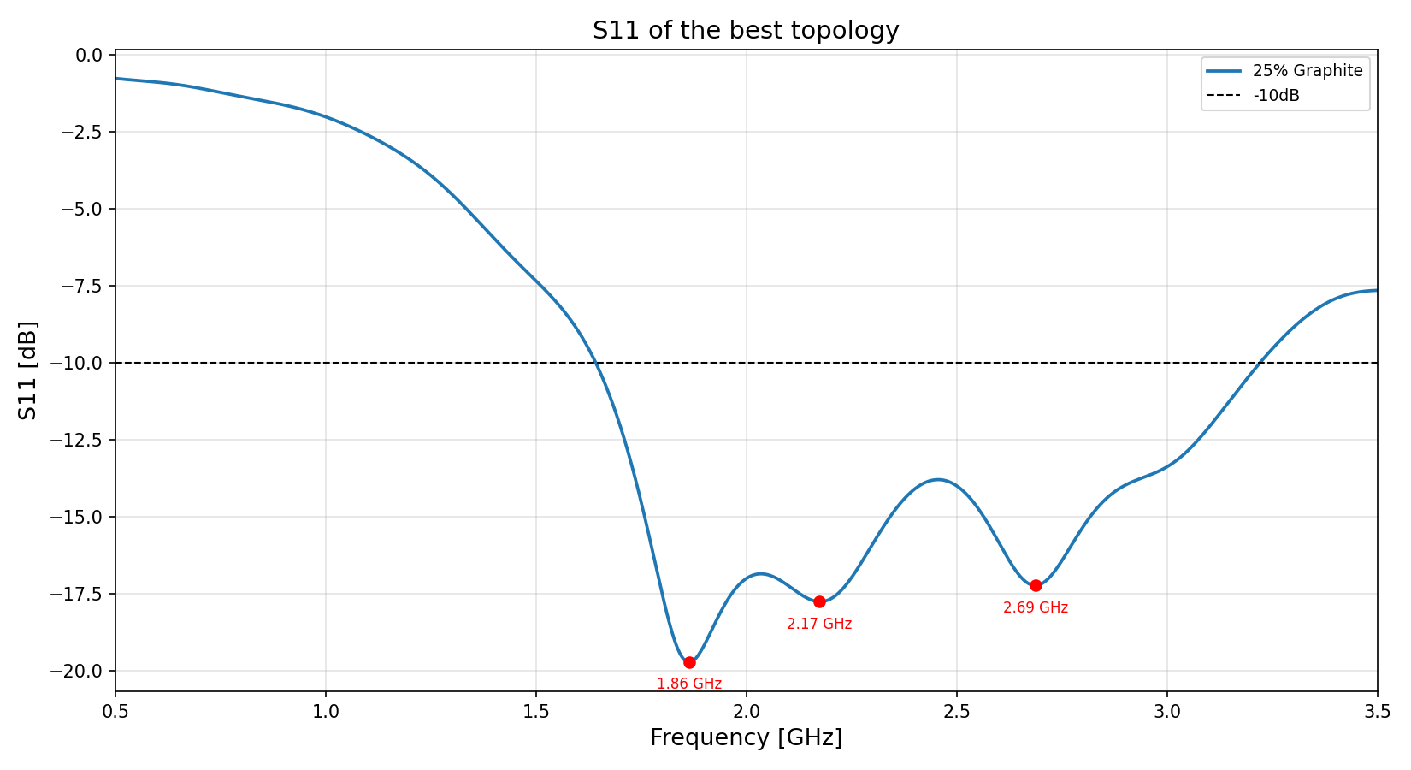
antenna_simulations/SPARAMS/S11_goodmodel.png
