AlexPeirano/neck_cst_simulation/antenna_simulations/SPARAMS/S11_graphite.png

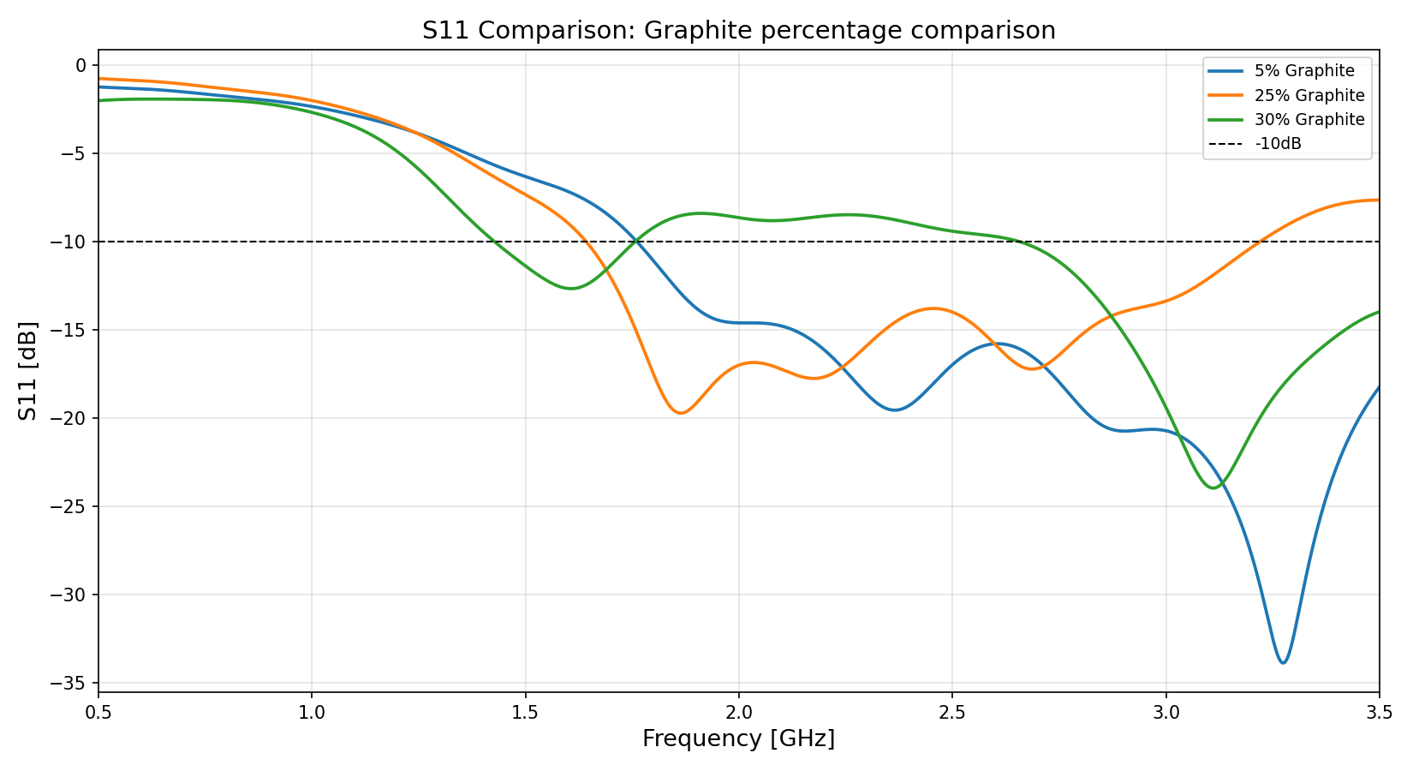
antenna_simulations/SPARAMS/S11_graphite.png
