AlexPeirano/neck_cst_simulation/antenna_simulations/SPARAMS/S21_good_model.png

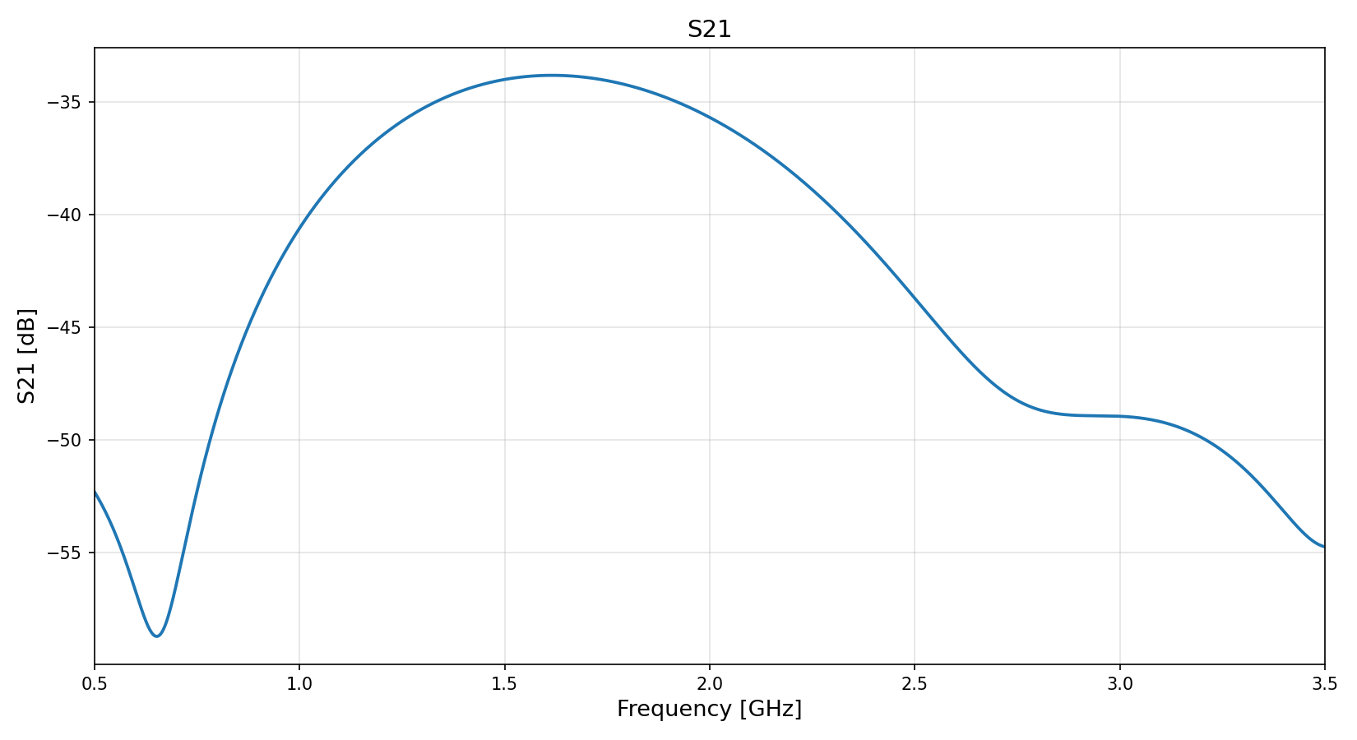
antenna_simulations/SPARAMS/S21_good_model.png
