AlexPeirano/neck_cst_simulation/antenna_simulations/SPARAMS/S21_graphites.png

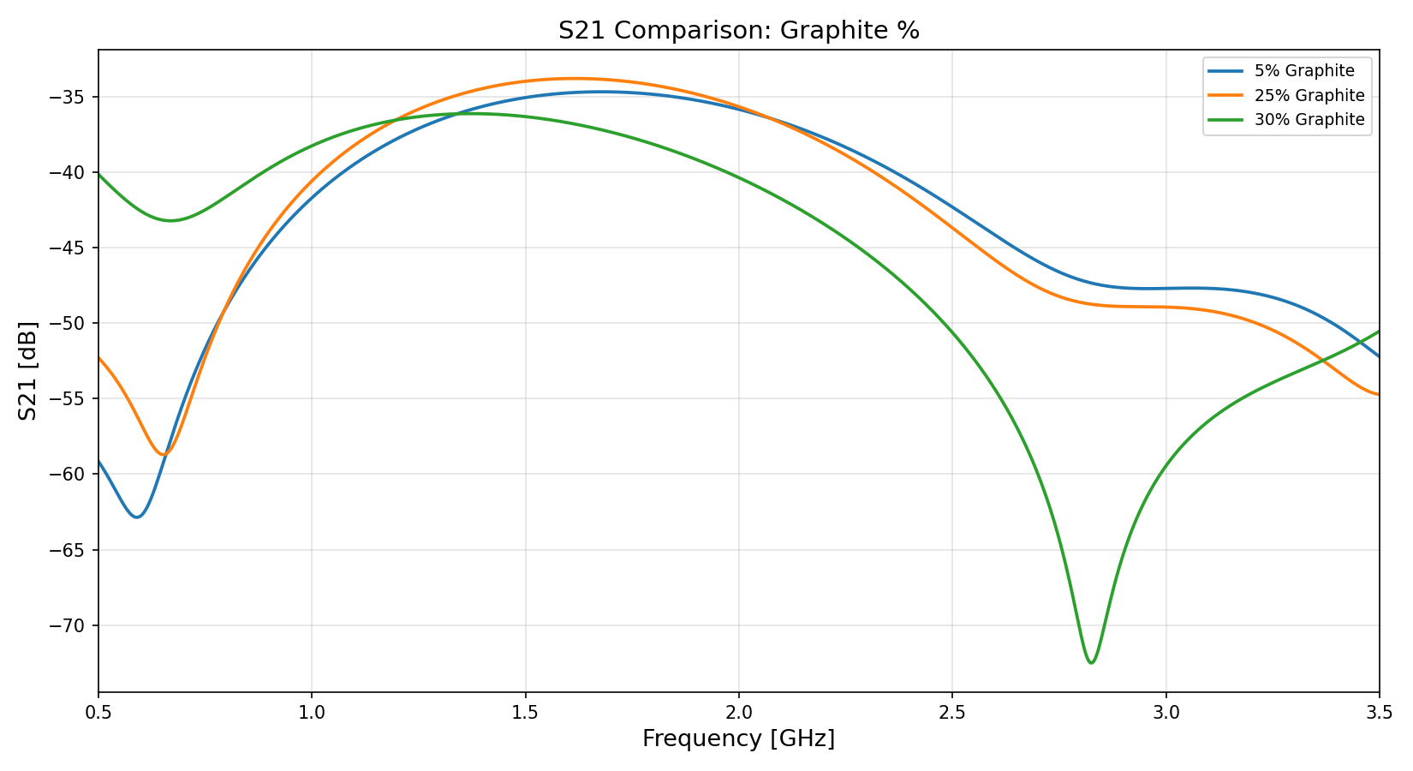
antenna_simulations/SPARAMS/S21_graphites.png
