AlexPeirano/neck_cst_simulation/plots/myNeck_graphite_combined_with_sim.png

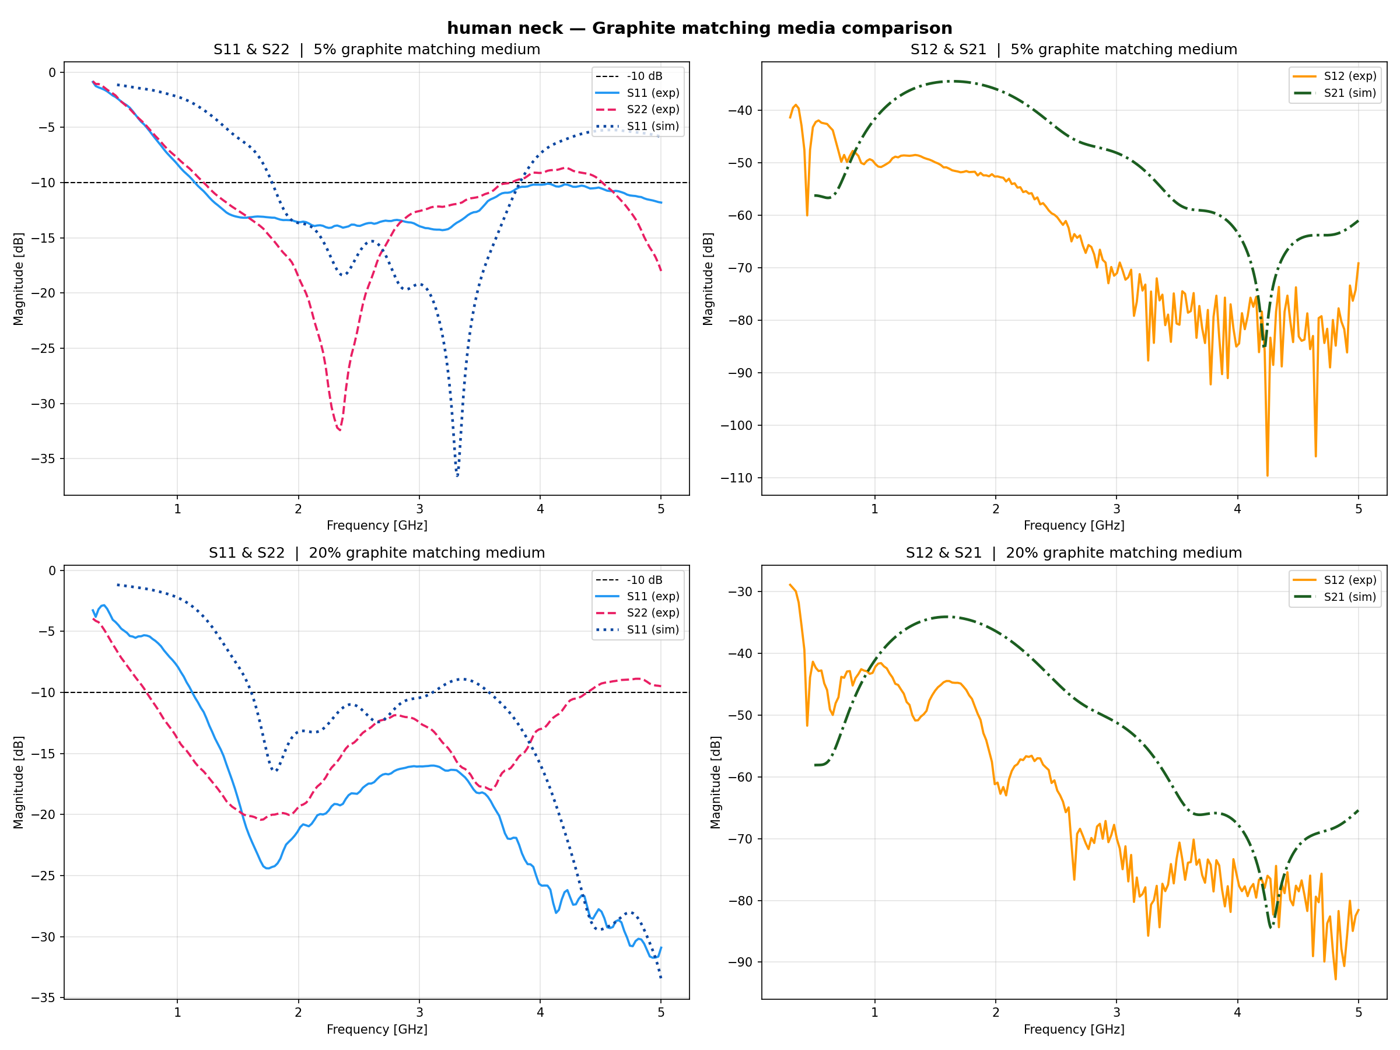
plots/myNeck_graphite_combined_with_sim.png
