AlexPeirano/neck_cst_simulation/plots/NeckPhantom_graphite_combined_with_sim.png

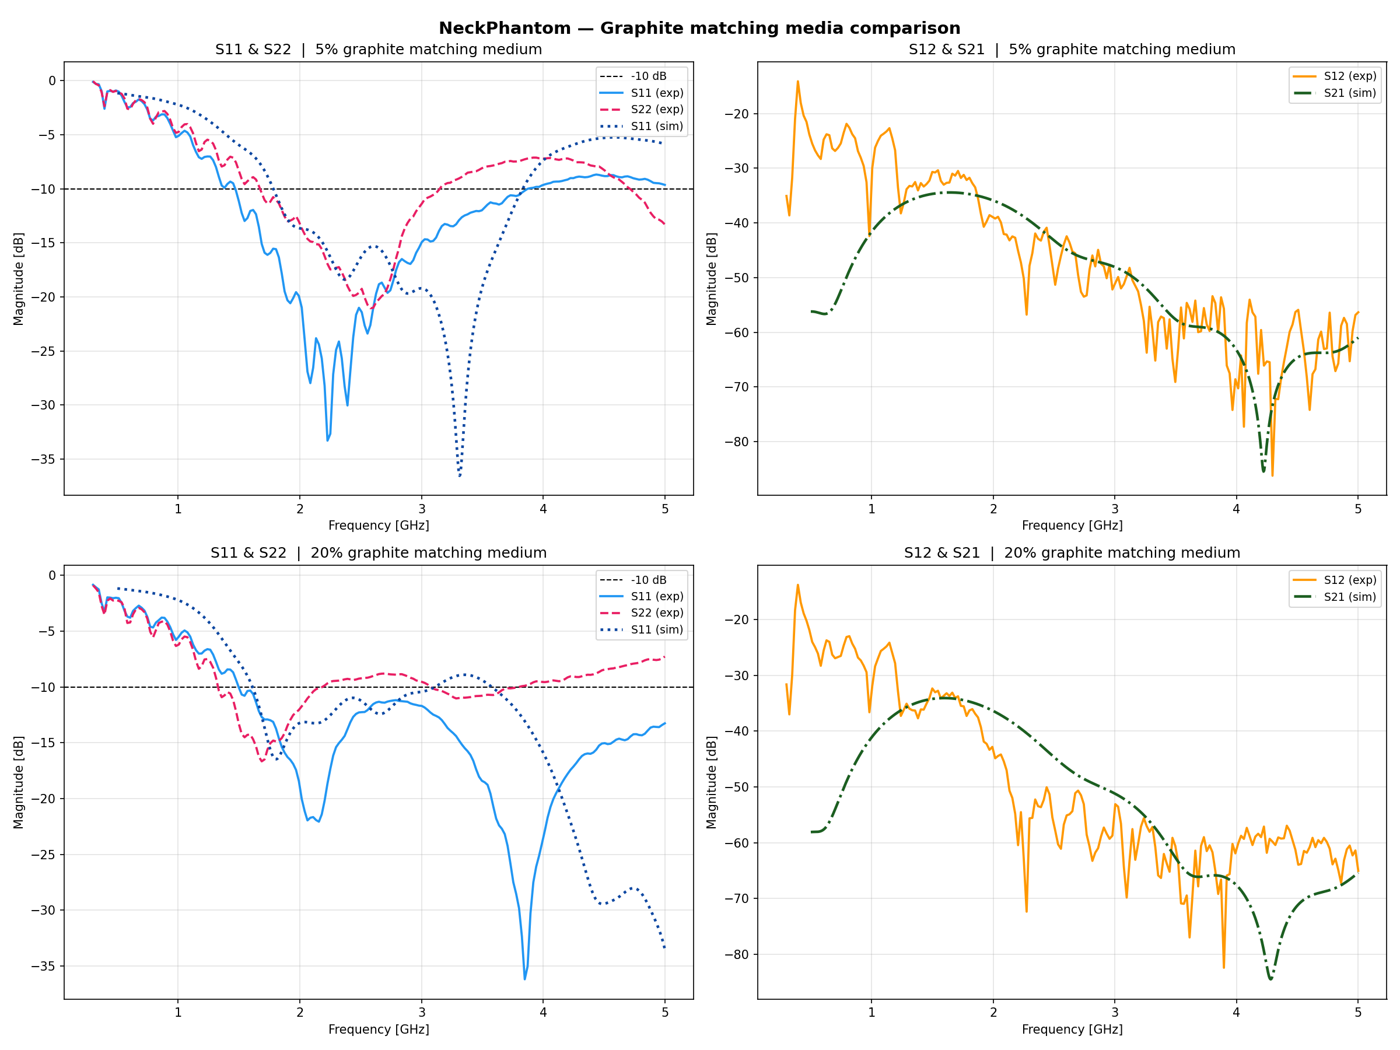
plots/NeckPhantom_graphite_combined_with_sim.png
