AlexPeirano/neck_cst_simulation/antenna_manufacturing/dxf/top.dxf

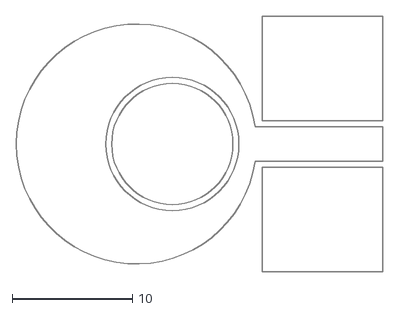
[picture p42: CAD file, 2026-06-30]
antenna_manufacturing/dxf/top.dxf
30.5 x 21.3
