AlexPeirano/neck_cst_simulation/antenna_manufacturing/dxf/bottom.dxf

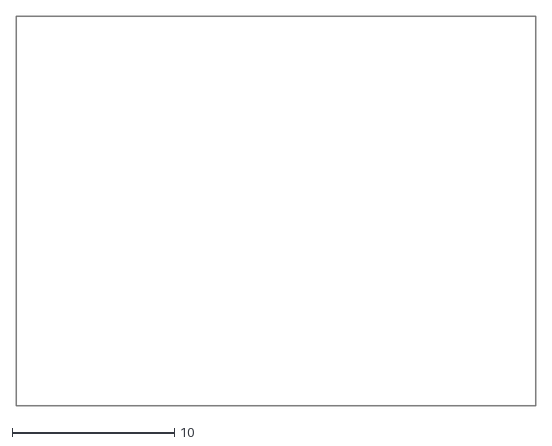
[picture p43: CAD file, 2026-06-30]
antenna_manufacturing/dxf/bottom.dxf
32.0 x 24.0
