AlexPeirano/neck_cst_simulation/antenna_simulations/surfacecurrent/results/hfield_dB.gif

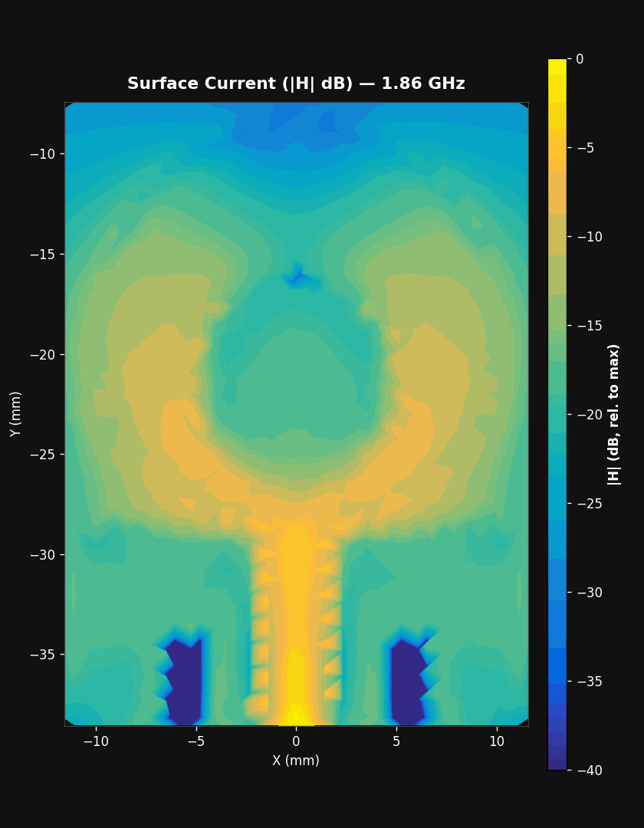
antenna_simulations/surfacecurrent/results/hfield_dB.gif
