AlexPeirano/neck_cst_simulation/plots/experiments_2_graphite_combined_with_sim.png

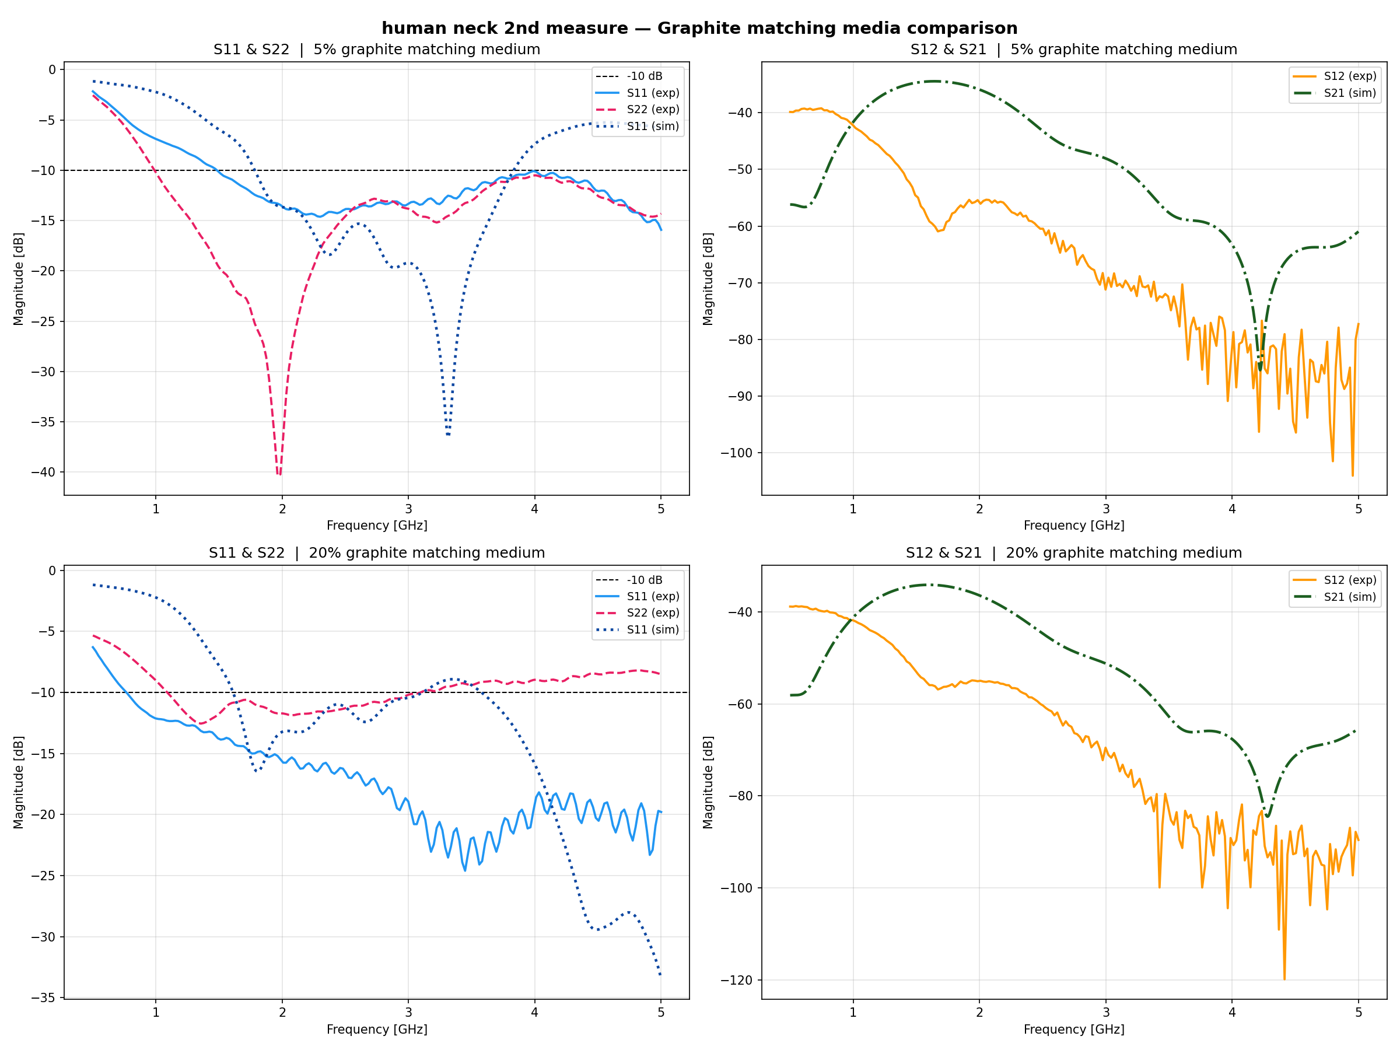
plots/experiments_2_graphite_combined_with_sim.png
