AlexPeirano/neck_cst_simulation/(commit log)

2026-05-29 1) Changed the interpolation to a bicubic one in order to smoothen the result plot 2) Corrected the 'depth' legend that was misplaced 3) Added the missing 'substrate' and 'coupling medium' layer
2026-06-08 further advancements on the antenna topology, include mostly plots
2026-06-12 Moved the git folder back, added new plots
    [sigma_epsilon_output.csv, spinalCord.csv, spinal_cord.csv, valid_G_N2.csv, valid_G_N3.csv, valid_G_N4.csv, whiteMatter.csv]
2026-06-15 Added a new type of plot : Surface current visualisation It includes a linear and dB visualisation
2026-06-30 This commit contains: gerber files of antenna data and computations for the making of the neck phantom including the calculation of the weighted complex permitivity and recipe to make a solution mimi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
    [3D_mould_cm.stl, average_dielectric.csv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]
2026-06-30 starting to organise the git
    [bottom.dxf, top.dxf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]
2026-07-07 Restructure repo: make final_git the root, remove intermediate task folders
    [3D_mould_cm.stl, average_dielectric.csv, bottom.dxf, sigma_epsilon_output.csv, spinalCord.csv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]
